patt502090/smart-voting-machine/temp/เครื่องลงคะแนนเสียงอัจฉริยะด้วย Arduino_ESP32.pdf

เครื่องลงคะแนนเสยงอัจฉริยะด้วย ี | Arduino/ESP32

## บทน;ำ

เครื่องลงคะแนนเสียงอัจฉริยะคือระบบเลือกตังอิเล็กทรอนิกส์ที่ผสมผสานเทคโนโลยีหลายอย่างเพื่อให้การลงคะแนนมีความ ้
ปลอดภัย โปร่งใส และรวดเร็ว ระบบนี้ใชไมโครคอนโทรลเลอร์ ้ | (เชน่ Arduino หรือ ESP32) ควบคุมอุปกรณ์ต่าง ๆ เชน่ เครื่อง
อ่านบัตร RFID, เซ็นเซอร์ลายนิ้วมือ, จอแสดงผล LCD, ปุ่มกดส;าหรับเลือกผู้สมัคร และโมดูลสื่อสาร Wi-Fi เพื่อส่งผลการโหวต ไปยังคอมพิวเตอร์แบบเรียลไทม์นอกจากนี้ยังสามารถต่อเครื่องพิมพ์ความร้อนขนาดเล็กเพื่อพิมพ์ใบเสร็จยืนยันการลงคะแนนให้
ผู้ใชได้ ้ ระบบได้รับการออกแบบให้รองรับทังโหมดการลงคะแนนแบบเลือกได้คนเดียว ้ | (Single Vote) และแบบเลือกได้หลายคน
พร้อมกัน (Multi-Choice Vote) สูงสุด 5 คน โดยมีมาตรการปองกันไม่ให้ผู้ใช ้ | คนเดียวลงคะแนนซ;้าด้วยการยืนยันตัวบุคคลสอง ้
ขันตอน ้ | (บัตร RFID และลายนิ้วมือ) | ทังนี้ ้ ตัวเครื่องต้นแบบถูกประกอบในกล่องหรือโครงสร้างที่ท;าจากกระดาษลัง DIY
เพื่อความสวยงามและสะดวกในการน;าเสนอผลงาน
คณสมบัติหลักของระบบ ุ | :
- โหมดกำรลงคะแนน: สามารถสลับระหว่างโหมดเลือกได้คนเดียว กับโหมดเลือกได้หลายคน (สูงสุด 5 คน) ตามประเภทของการ เลือกตัง้
- กำรยืนยันตัวตนสองชนั้ : ผู้มีสิทธิลงคะแนนต้องแตะบัตร ์ | RFID และสแกนลายนิ้วมือก่อนลงคะแนน เพื่อปองกันการ ้
ปลอมแปลงและลงคะแนนซ;้า ผู้ใชแต่ละคนจะลงคะแนนได้เพียงครั ้ | งเดียวเท่านั ้ | น้ หากมีการพยายามลงคะแนนซ;้า ระบบจะปฏิเสธ
ทันที
- ส่วนติดต่อผู้ใช:้ มีจอ LCD ส;าหรับแสดงค;าแนะน;า/สถานะการท;างาน และปุ่มกดสูงสุด 8 ปุ่มส;าหรับเลือกผู้สมัครที่ต้องการลง คะแนน (รองรับผู้สมัครได้สูงสุด 8 คน)
- กำรส่งข้อมูลผลโหวต: ใชความสามารถ ้ | Wi-Fi ของ ESP32 ในการส่งข้อมูลผลการลงคะแนนไปยังคอมพิวเตอร์ (เชน่
ODROID หรือ PC) แบบไร้สาย เพื่อแสดงผลคะแนนบนแดชบอร์ดแบบเรียลไทม์ผู้ควบคุมสามารถดูผลคะแนนสะสมได้ทันทีที่มี การลงคะแนนใหม่เข้ามา
- กำรพิมพ์ใบยืนยัน: หลังจากผู้ใชลงคะแนนส;าเร็จ ้ | ระบบสามารถพิมพ์ใบเสร็จยืนยันการลงคะแนนผ่านเครื่องพิมพ์ความร้อน
(thermal printer) ขนาดเล็ก เพื่อให้ผู้ลงคะแนนตรวจสอบว่าเสียงของตนถูกบันทึกเรียบร้อย (แนวคิดคล้าย VVPAT ในการ
เลือกตังจริง ้ | )
- กำรออกแบบโครงสร้ำง: ชุดอุปกรณ์ทังหมดติดตั ้ | งอยู่ในกล่องหรือคูหาท;าจากวัสดุอย่างกระดาษลัง ้ | ซึ่งออกแบบ DIY ให้
ดูเหมือนตู้ลงคะแนนเสียงขนาดเล็ก มีความแข็งแรงพอประมาณและตกแต่งให้สวยงาม เหมาะแก่การน;าไปแสดงในงานโครงงาน นักศึกษา
ด้านล่างนี้จะเป็นรายละเอียดเชงลึกของระบบ ิ | ตังแต่ส่วนประกอบฮาร์ดแวร์ ้ | การต่อวงจร ผังงานการท;างาน โค้ดโปรแกรมทังฝั ้ ่ง
ไมโครคอนโทรลเลอร์และฝั่งคอมพิวเตอร์ รวมถึงวิธีเตรียมฐานข้อมูลผู้มีสิทธิและขั ์ | นตอนการท;างานของระบบแบบเป็นล;าดับ ้

## อุปกรณ์และกำรต่อวงจร

ระบบประกอบด้วยฮาร์ดแวร์ส;าคัญหลายรายการดังต่อไปนี้:

ไมโครคอนโทรลเลอร์: สามารถใช้Arduino UNO/MEGA หรือ ESP32 เป็นหน่วยประมวลผลกลางของระบบ (แนะน;า
ใช้ESP32 เพื่อความสะดวกในการเช่อมต่อ ื | Wi-Fi ในตัว)
เครื่องอ่ำน RFID: โมดูล MFRC522 (RFID RC522) ใชส;าหรับอ่านบัตรประจ;าตัวผู้มีสิทธิ ้ | ลงคะแนน ความถี่ ์ | 13.56
MHz สื่อสารผ่านอินเทอร์เฟซแบบ SPI

1 (https://www.researchgate.net/publication/347968409_Arduino_Based_Authenticated_Voting_Machine_AVM_using_RFID_and_Fingerprint_for_the_Student_Elections) 2

2 (https://www.researchgate.net/publication/347968409_Arduino_Based_Authenticated_Voting_Machine_AVM_using_RFID_and_Fingerprint_for_the_Student_Elections)

•

•

3 (https://www.researchgate.net/publication/347968409_Arduino_Based_Authenticated_Voting_Machine_AVM_using_RFID_and_Fingerprint_for_the_Student_Elections)

เซนเซอร์ลำยนิ ็ | ้วมือ: โมดูล AS608 (หรือรุ่นใกล้เคียงเชน ่ R305) ใชสแกนลายนิ ้ | ้วมือผู้ลงคะแนน ตัวโมดูลมีหน่วยความ
จ;าภายในส;าหรับเก็บเทมเพลตลายนิ้วมือประมาณ 128 ลายนิ้วมือ และสื่อสารผ่านพอร์ตอนุกรม (UART) กับไมโคร คอนโทรลเลอร์
จอ LCD: จอแสดงผลตัวอักษร 16x2 (16 คอลัมน์ 2 แถว) หรือ 20x4 เพื่อใชแสดงข้อความสถานะต่าง ๆ เช ้ | น พร้อมให้ ่
ลงคะแนน, ยืนยันตัวตน, ข้อผิดพลาด เป็นต้น (ในที่นี้จะอ้างอิง 16x2 เพื่อความง่าย)
ปุ่มกด (Push Buttons): ใชส;าหรับเลือกผู้สมัครที่ต้องการลงคะแนน โดยสามารถมีได้สูงสุด ้ | 8 ปุ่ม (รองรับผู้สมัคร 8
หมายเลข) การต่อวงจรจะใชปุ่มแบบ ้ | Momentary (กดติดปล่อยดับ) ต่อลงไปยังขาพอร์ตดิจิทัลของไมโครคอนโทรล
เลอร์ พร้อมตัวต้านทาน Pull-down หรือใช้Internal Pull-up ของ MCU เพื่อให้ตรวจจับสถานะการกดได้
บัซเซอร์/LED (อุปกรณ์เสริม): บัซเซอร์ใชส่งเสียงแจ้งเตือนเมื่อมีเหตุการณ์บางอย่าง เช ้ | น สแกนบัตรผ่านหรือเกิดข้อ ่
ผิดพลาด LED สีเขียว/แดงสามารถใชแสดงสถานะพร้อมลงคะแนนหรือการยืนยันตนผ่าน ้ | (อุปกรณ์เสริมนี้ไม่ได้ระบุใน
คุณสมบัติหลัก แต่สามารถเพิมได้เพื่อเพิ ่ | มประสบการณ์ผู้ใช ่ | ) ้
โมดูล Wi-Fi: หากใช้ESP32 จะมี Wi-Fi ในตัว แต่หากใช้Arduino อาจต้องต่อโมดูล Wi-Fi แยกต่างหาก (เชน่ ESP8266) อย่างไรก็ตาม ในที่นี้เราเลือกใช้ESP32 เป็นหลักเพราะรวม Wi-Fi กับ MCU ไว้ในตัวเดียว
เครื่องพิมพ์ควำมร้อน (Thermal Printer): เป็นเครื่องพิมพ์ใบเสร็จขนาดเล็กที่ใชกระดาษความร้อน ้ | 58 มม. เช่อมื
ต่อผ่าน Serial TTL (ต้องการไฟเลี้ยง 5V แยกต่างหาก) เพื่อพิมพ์ข้อความยืนยันการลงคะแนนเมื่อโหวตส;าเร็จ (การต่อ พ่วงเป็นทางเลือกเพิมเติม ่ )
ส;าหรับการต่อวงจร Arduino/ESP32 กับอุปกรณ์ข้างต้น มีรายละเอียดดังนี้:

กำรต่อโมดูล RFID RC522: โมดูล RC522 ท;างานที่ไฟ 3.3V (ควรใช 3.3V ้ เพื่อความปลอดภัยของตัวโมดูล) และ สื่อสารด้วย SPI ขาของ RC522 ได้แก่ SDA (SS), SCK, MOSI, MISO, IRQ, RST, 3.3V, GND โดยการต่อกับ ESP32 (ตัวอย่างใช้ESP32 DevKit V1) จะต่อ SDA → GPIO 5, SCK → GPIO 18, MOSI → GPIO 23, MISO →
GPIO 19, RST → GPIO 21, และใชไฟ้ 3.3V, GND ตามล;าดับ | (ESP32 สามารถปรับเปลี่ยนขา SPI ได้ แต่
ตัวอย่างนี้ใช้SPI ชุดเริมต้น ่ | (VSPI) ของ ESP32)
กำรต่อเซนเซอร์ลำยนิ ็ | ้วมือ: โมดูล AS608 มีสายเช่อมต่อ ื | 4 เส้นหลักคือ VCC (ไฟเลี้ยง 3.3V-5V), GND, TX, RX โดย
TX/RX ของเซ็นเซอร์จะต่อเข้ากับ RX2 และ TX2 ของ ESP32 (หรือหากใช้Arduino UNO สามารถใช้
SoftwareSerial ในการรับส่งข้อมูลได้) การเช่อมต่อคือเซ็นเซอร์ ื | TX → RX ของ MCU, เซ็นเซอร์ RX → TX ของ
MCU และจ่ายไฟให้เซ็นเซอร์ที่ 3.3V หรือ 5V ตามสเปค (AS608 รองรับ 3.3V)
กำรต่อจอ LCD 16x2: ถ้าใชจอ ้ LCD พร้อม I2C backpack จะง่ายขึ้น โดยต่อเพียง 4 เส้นคือ VCC (5V), GND, SDA, SCL จากโมดูล I2C ไปยังขา SDA/SCL ของ MCU (เชน ่ SDA → GPIO 21, SCL → GPIO 22 บน ESP32 หรือ
A4, A5 บน Arduino UNO ตามล;าดับ) | แต่หากใชการต่อแบบขนาน ้ | 4-bit (ไม่มี I2C backpack) จะต้องต่อสาย
หลายเส้น: ขา RS, EN, D4-D7 ของ LCD ไปยังขาดิจิทัลของ MCU และต่อไฟเลี้ยง/ปรับแสงตามปกติ (ในตัวอย่าง Arduino UNO: RS→D13, EN→D12, D4→D11, D5→D10, D6→D9, D7→D8)
กำรต่อปุ่มกด: ปุ่มกดแต่ละตัวมีขา 2 ขา (หรือ 4 ขาส;าหรับปุ่มแบบมีขาเผื่อ) การต่อวงจรนิยมต่อแบบหนึ่งขาเข้าขา อินพุตของ MCU และอีกขาหนึ่งลง GND จากนันใช ้ ้Pull-up ภายใน MCU (INPUT_PULLUP) เพื่อให้สถานะปกติของ ปุ่มเป็น HIGH และเมื่อกดจะต่อขาเข้าลง GND (อ่านค่า LOW เมื่อกด) ซึ่งวิธีนี้ลดจ;านวนอุปกรณ์เพราะไม่ต้องใชตัว ้ ต้านทานภายนอก (หรือจะต่อแบบหนึ่งขาเข้าขาอินพุต หนึ่งขาไป VCC และใช้Pull-down resistor ก็ได้) แต่หลักการคือ เมื่อกดปุ่มให้เกิดการเปลี่ยนสถานะโลจิกที่ตรวจจับได้
กำรต่อบัซเซอร์/LED: (ถ้ามี) บัซเซอร์แอคทีฟ 5V สามารถต่อขา + ไปขา MCU (ผ่านทรานซิสเตอร์ถ้ากระแสเกิน) และขา
– ลง GND เพื่อให้ MCU สังเสียงได้ ส;าหรับ ่ | LED ให้ต่อขา Anode ผ่านตัวต้านทาน ~220Ω ไปยังขา MCU และขา
Cathode ลง GND (ไฟ 3.3V ของ ESP32 สามารถไดรฟ LED ได้โดยตรง) ด้านล่างเป็นแผนภาพบล็อกและแผนผังวงจรเพื่อความเข้าใจในการต่อระบบทังหมด ้ :

แผนภาพบล็อกของระบบเครื่องลงคะแนนเสียงแบบ biometric (ยืนยันตัวบุคคลด้วยลายนิ้วมือและ RFID) โดยมีไมโครคอนโทรล
เลอร์ Arduino เป็นศูนย์กลางเช่อมต่อกับจอ ื | LCD (ส;าหรับแสดงผลข้อความ), โมดูลสแกนลายนิ้วมือ, เครื่องอ่านบัตร RFID และ
ปุ่มกดส;าหรับลงคะแนน | แต่ละองค์ประกอบท;างานร่วมกันเพื่อให้การลงคะแนนมีความปลอดภัยและแม่นย;า

•

•

•

•

•

•

•

4 (https://randomnerdtutorials.com/esp32-mfrc522-rfid-reader-arduino/)

•

•

5 (https://www.electroniclinic.com/rfid-fingerprint-based-advanced-security-system-using-arduino/)

6 (https://circuitdigest.com/microcontroller-projects/fingerprint-based-biometric-voting-machine-arduino)
•

•

7 (https://transmitter.ieee.org/makerproject/view/01ccd)

จากแผนภาพบล็อกข้างต้น จะเห็นว่าหลังจากผู้ใชได้รับการตรวจสอบสิทธิ ้ | ผ่าน ์ | RFID และลายนิ้วมือ ไมโครคอนโทรลเลอร์จะ
อนุญาตให้กดปุ่มลงคะแนนเลือกผู้สมัครที่ต้องการ จากนันจึงบันทึกและส่งผลไปยังส่วนประมวลผลผลโหวตผ่าน ้ | Wi-Fi โดยจะ
แสดงผลบนคอมพิวเตอร์แบบเรียลไทม์ ขันตอนเหล่านี้จะถูกอธิบายอย่างละเอียดในส่วนถัดไป ้
แผนผังวงจรการเช่อมต่ออุปกรณ์ทั ื | งหมด ้ | (ตัวอย่างการใช้ Arduino Uno): โมดูลสแกนลายนิ้วมือต่อเข้าขา Tx/Rx ของ
Arduino, จอ LCD ต่อในโหมด 4-bit (ขา RS, EN, D4-D7 ต่อเข้าขา D13,D12,D11,D10,D9,D8 ของ Arduino), และปุ่มกด
หลายตัวต่อเข้าขาอินพุตส;าหรับผู้สมัคร CAN1, CAN2, CAN3 (ในภาพตัวอย่างมี 3 ผู้สมัคร) พร้อมทังปุ่มส;าหรับฟังก์ช ้ | นอื่นๆ ั | เชน่
Enroll, Delete เป็นต้น (ต่อเข้าขา A0-A4) | ในการใชงานจริงสามารถเพิ ้ | ่มจ;านวนปุ่มผู้สมัครได้ถึง 8 ปุ่มตามที่ระบบต้องการ

หมำยเหตุ: หากใช้ESP32 แทน Arduino ในการต่อวงจรจริง ขา I/O บน ESP32 จะต่างออกไป แต่หลักการ
ต่อเหมือนกัน (RFID ใช SPI, ้ | เซ็นเซอร์ลายนิ้วมือใช UART, ้ | จอ LCD ใช I2C ้ | หรือ 4-bit parallel, ปุ่มกดต่อเข้า
GPIO ทัวไป ่ ) ต้องระมัดระวังเรื่องแรงดันไฟ: ESP32 ท;างานที่ระดับตรรกะ 3.3V ดังนันโมดูลทั ้ | งหมดควรใช ้ | ้
3.3V หรือต่อวงจรแปลงระดับแรงดัน (logic level shifter) ถ้าจ;าเป็น (เชน่ จอ LCD 16x2 ถ้าไม่มี I2C module อาจต้องใช 5V ้ แต่ว่าสัญญาณจาก ESP32 3.3V ก็มักเพียงพอในการขับให้ LCD รับรู้เป็น High ได้)

เมื่อฮาร์ดแวร์ทุกส่วนต่อครบถ้วนดังผังวงจรแล้ว ก็พร้อมส;าหรับการเขียนโปรแกรมควบคุมส่วนต่าง ๆ และด;าเนินการตาม ขันตอนการลงคะแนนเสียง ซึ่งจะอธิบายในล;าดับถัดไป ้

## ผังงำนของระบบ

ด้านล่างเป็นผังงาน (Flowchart) โดยสรุปขันตอนการท;างานของเครื่องลงคะแนนเสียงอัจฉริยะ ้ | ตังแต่การเริ ้ | มต้นระบบไปจนถึง ่
จบการลงคะแนนในแต่ละคน
ผังงานแสดงล;าดับกระบวนการของระบบลงคะแนนเสียง: เริมจากรอให้ผู้ใช ่ | สแกนบัตร ้ | RFID และลายนิ้วมือเพื่อยืนยันสิทธิ์ หาก
ตรวจสอบผ่านและยังไม่เคยลงคะแนนมาก่อน ระบบจะอนุญาตให้ลงคะแนนได้ แต่หากลายนิ้วมือไม่ตรงกับข้อมูลที่ลงทะเบียนไว้
หรือผู้ใชคนเดิมพยายามลงคะแนนซ;้า ระบบจะปฏิเสธการลงคะแนน ้ | (ยกเลิกกระบวนการ) | จากนันจึงวนกลับไปรอผู้ใช ้ | คนถัดไป ้

จากผังงานจะเห็นว่าระบบมีเงื่อนไขที่ส;าคัญคือ กำรตรวจสอบสิทธิ์ และ กำรตรวจจับกำรลงคะแนนซ้ำ; เพื่อรักษาความถูกต้อง ของการเลือกตัง กระบวนการละเอียดจะขยายความในหัวข้อถัดไป ้
ขันตอนกำรลงคะแนน ้ | (Step-by-Step Workflow)
เพื่อให้เข้าใจการท;างานของระบบอย่างเป็นล;าดับต่อเนื่อง ขอน;าเสนอขันตอนการลงคะแนนของผู้ใช ้ | หนึ่งคน ดังนี้ ้ | :
ผู้ใชแสดงตัวตนด้วยบัตร ้ | RFID: ผู้ลงคะแนนน;าบัตรประจ;าตัว (ที่มีแท็ก RFID) แตะที่เครื่องอ่าน RFID RC522 ที่หน้า
ตู้ เครื่องอ่านจะตรวจจับการ์ดและอ่านรหัสประจ;าบัตร (UID) ออกมาได้ส;าเร็จ (บัตร RFID ทุกใบจะมี UID ที่ไม่ซ;้ากันเพื่อ
ระบุผู้ถือบัตรแต่ละคน | )
ตรวจสอบ UID กับฐำนข้อมูลผู้มสิทธิ ี :์ ไมโครคอนโทรลเลอร์จะน;า UID ที่อ่านได้ไปค้นหาในรายช่อผู้มีสิทธิ ื | ในหน่วย ์
ความจ;า/ฐานข้อมูล หากไม่พบหมายเลขบัตรนี้ในระบบ แสดงว่าเป็นบัตรที่ไม่มีสิทธิหรือไม่ถูกต้อง ระบบจะแสดงผลบน ์
LCD ว่า “ไม่มีสิทธิ” ์ หรือ “Unauthorized” และกระบวนการจะสินสุดลงทันทีส;าหรับบุคคลนั ้ | น ้
ยืนยันตัวตนด้วยลำยนิ้วมือ: หาก UID บัตรตรงกับรายช่อผู้มีสิทธิ ื | ระบบจะแสดงข้อความบน ์ | LCD ให้ผู้ใช “้ วางนิ้วเพื่อ
ตรวจสอบ” จากนันผู้ใช ้ | ต้องวางนิ ้ | ้วที่ลงทะเบียนไว้บนเซ็นเซอร์ลายนิ้วมือ AS608 ระบบจะสแกนลายนิ้วมือและเทียบกับ
ข้อมูลลายนิ้วมือในฐานข้อมูลที่ผูกกับหมายเลขบัตร RFID นันๆ เพื่อยืนยันว่าบุคคลที่ถือบัตรคือเจ้าของสิทธิ ้ | ตัวจริง ์ | (การ
ใชสองปัจจัยนี้ช ้ | วยรับประกันว่าบัตรเป็นของเจ้าของที่แท้จริง ไม่ใช ่ | หยิบยืมผู้อื่นมา ่ | )
ตรวจสอบสถำนะกำรลงคะแนน: หากลายนิ้วมือตรงกับข้อมูลในระบบ (ผ่านการยืนยันตัวบุคคล) โปรแกรมจะตรวจเชค็
ต่อว่าผู้มีสิทธิรายนี้เคยลงคะแนนไปแล้วหรือยังโดยการดูสถานะ ์ | “hasVoted” ในฐานข้อมูลของบุคคลนันๆ้ – ถ้าพบว่า
เคยลงคะแนนแล้ว ระบบจะปฏิเสธการลงคะแนนซ;้าทันที จะแจ้งเตือนบนหน้าจอว่า “คุณได้ลงคะแนนแล้ว” และสินสุด ้

6 (https://circuitdigest.com/microcontroller-projects/fingerprint-based-biometric-voting-machine-arduino)

2 (https://www.researchgate.net/publication/347968409_Arduino_Based_Authenticated_Voting_Machine_AVM_using_RFID_and_Fingerprint_for_the_Student_Elections)

1.

8 (https://www.researchgate.net/publication/347968409_Arduino_Based_Authenticated_Voting_Machine_AVM_using_RFID_and_Fingerprint_for_the_Student_Elections)
2.

3.

9 (https://www.researchgate.net/publication/347968409_Arduino_Based_Authenticated_Voting_Machine_AVM_using_RFID_and_Fingerprint_for_the_Student_Elections)
4.

| กระบวนการส;าหรับผู้ใชรายนี้ ้ | (มาตรการนี้ท;าให้หนึ่งคนลงคะแนนได้เพียงหนึ่งครังตามหลักการ ้ | | one person, one vote
)
เลือกรูปแบบกำรลงคะแนน (Single/Multi): กรณีผู้ใชยังไม่เคยลงคะแนน ระบบจะเข้าสู่โหมดลงคะแนน โดยจะแสดง ้
ข้อความให้เลือกผู้สมัครบนจอ LCD (เชน่ “เลือกผู้สมัคร”) โหมดการลงคะแนนขึ้นอยู่กับการตังค่าของระบบในขณะนั ้ | น้ :
โหมดเลือกคนเดียว: ระบบจะอนุญาตให้กดปุ่มเลือกผู้สมัครได้เพียงคนเดียว เมื่อผู้ใชกดปุ่มหมายเลขผู้สมัคร ้ | (เชน ปุ่ม ่
หมายเลข 3 เพื่อเลือกผู้สมัครหมายเลข 3) ระบบจะบันทึกตัวเลือกนันแล้วถือว่าการลงคะแนนเสร็จสิ ้ | น ้
โหมดเลือกหลายคน: ระบบจะอนุญาตให้เลือกผู้สมัครได้หลายคนภายในการลงคะแนนครังเดียว ้ | (เชน เลือกได้สูงสุด ่ | 5
คน) กรณีนี้ผู้ใชสามารถกดปุ่มผู้สมัครได้ทีละคน ระบบจะนับจ;านวนที่เลือกไป และแสดงผลจ;านวนที่เลือกแล้ว ้ | /จ;านวนสูง
สุดบน LCD (เชน่ “เลือกแล้ว 2/5”) ผู้ใชจะกดจนครบตามจ;านวนที่อนุญาต ระบบจะไม่อนุญาตให้เลือกเกินที่ก;าหนด ้ | (ถ้า
ครบ 5 คนแล้ว ปุ่มที่กดเพิมเติมจะไม่มีผล หรืออาจต้องมีปุ่ม ่ | “ยืนยัน” แยกต่างหากเพื่อสินสุดการเลือก ้ | )
บันทึกผลโหวต: เมื่อผู้ใชเลือกผู้สมัครครบตามที่ระบบก;าหนดในโหมดนั ้ | นๆ แล้ว ไมโครคอนโทรลเลอร์จะท;าการบันทึก ้
คะแนนเสียงลงในตัวแปรหรือหน่วยความจ;าที่เก็บ ตัวนับคะแนน ของผู้สมัครแต่ละคน โดยจะเพิมค่า ่ | +1 ให้แก่ผู้สมัครที่
ถูกเลือก (ส;าหรับโหมดเลือกหลายคน ผู้สมัครแต่ละคนที่ถูกเลือกจะได้ +1 ในตัวนับคะแนนของตน)
อัปเดตสถำนะผู้ใช:้ ระบบท;าเครื่องหมายในฐานข้อมูลว่าผู้ใชคนนี้ ้ | “ลงคะแนนแล้ว” (เชน ตั ่ งค่าตัวแปร ้ | hasVoted =
true ส;าหรับผู้ใชรายนี้ ้ | ) เพื่อปองกันไม่ให้เขากลับมาลงคะแนนซ;้าอีกในภายหลัง ้
ส่งข้อมูลผลกำรเลือกตั้งไปยังเซร์ฟเวอร์ ิ | : หลังการบันทึกคะแนนในเครื่องแล้ว ไมโครคอนโทรลเลอร์ (ESP32) จะท;า
การส่งข้อมูลผลการลงคะแนนไปยังคอมพิวเตอร์แม่ข่าย (Server) ผ่านทาง Wi-Fi ทันที ข้อมูลที่ส่งอาจเป็นรายละเอียด การโหวตครังนี้หรือยอดรวมคะแนนล่าสุดของทุกผู้สมัครก็ได้ ข้อมูลจะถูกส่งด้วยรูปแบบที่ตกลงกันระหว่างไมโคร ้ คอนโทรลเลอร์กับโปรแกรมฝั่งคอมพิวเตอร์ (อาจใช้HTTP request, WebSocket หรือ MQTT แล้วแต่การออกแบบ ในที่นี้จะยกตัวอย่างการส่งผ่าน HTTP) เมื่อเซิร์ฟเวอร์ได้รับข้อมูลแล้ว จะน;าไปปรับปรุงแดชบอร์ดแสดงผลคะแนนแบบ
| เรียลไทม์บนหน้าจอคอมพิวเตอร์
กำรพิมพ์ใบยืนยัน (ถ้ำม):ี หากระบบมีการต่อเครื่องพิมพ์ความร้อนไว้ ไมโครคอนโทรลเลอร์จะสังพิมพ์ใบเสร็จยืนยันการ ่
ลงคะแนนให้แก่ผู้ใช เช้ น พิมพ์ข้อความว่า ่ | “การลงคะแนนเสร็จสมบูรณ์”, รหัสของผู้ใช (้ หรือหมายเลขบัตร) และเวลาที่ลง
คะแนน เป็นต้น ทังนี้เพื่อเป็นหลักฐานให้ผู้ลงคะแนนสามารถตรวจสอบความถูกต้องในภายหลัง ้ | (ข้อความในใบเสร็จจะไม่
ระบุช่อผู้สมัครที่เลือก เพื่อรักษาความลับของบัตรเลือกตั ื | ง้ )
สินสุดและพร้อมรับคนถัดไป ้ | : ระบบแสดงข้อความ “ลงคะแนนส;าเร็จ” หรือข้อความขอบคุณบน LCD สักครู่ จากนันจะรี ้
เซ็ตกลับไปสู่สถานะพร้อมใชงานส;าหรับผู้มีสิทธิ ้ | คนถัดไป ์ | (กลับไปที่ขันตอนรอบัตร ้ | RFID) โดยหากมีไฟ LED สถานะก็อาจ
กระพริบแจ้งเตือนสัน ๆ ร่วมด้วยว่ากระบวนการส;าหรับคนนี้เสร็จสิ ้ | นแล้ว ้
ขันตอนข้างต้นจะเกิดขึ้นซ;้า ้ | ๆ ทุกครังที่มีผู้มาใช ้ | สิทธิ ้ ลงคะแนนจนกว่าจะครบทุกคนหรือจนกว่าจะสิ ์ | นสุดเวลาลงคะแนน ้ | ข้อมูลผล
การลงคะแนนทุกครังจะถูกบันทึกไว้ทั ้ | งในตัวเครื่องและส่งไปยังระบบศูนย์กลางตลอดเวลาเพื่อความโปร่งใสและปลอดภัย ้
กำรเตรยมฐำนข้อมูลผู้ม ี | สิทธิ ี ์
ระบบนี้ต้องมีฐำนข้อมูลรำยช่อผู้ม ื | สิทธิ ี ์ที่ประกอบด้วยข้อมูลสองส่วนที่เช่อมโยงกัน ื | ได้แก่ รหัสบัตร RFID และ เทมเพลตลำย
นิ้วมือ ของผู้มีสิทธิแต่ละคน ์ | การเตรียมฐานข้อมูลนี้ควรท;าเป็นขันตอนก่อนวันใช ้ | งานจริง ้ | (pre-enrollment) โดยอาจด;าเนินการ
ดังนี้:
กำรลงทะเบยนบัตร ี | RFID: แจกจ่ายบัตร RFID ให้แก่ผู้มีสิทธิแต่ละคน ์ | (เชน นักศึกษาแต่ละคนในกรณีเลือกตั ่ | งองค์การ ้
นักศึกษา) จากนันอ่าน ้ | UID ของบัตรแต่ละใบและบันทึกลงในระบบพร้อมเช่อมโยงกับข้อมูลบุคคล ื | (เชน ช ่ ่อ หรือรหัส ื
นักศึกษา เพื่อทราบว่า UID ใดเป็นของใคร)
กำรเก็บลำยนิ้วมือ: ใชเซ็นเซอร์ลายนิ ้ | ้วมือ AS608 เช่อมต่อกับ ื | Arduino/ESP32 รันโปรแกรม enrollment (มีอยู่ใน
ไลบรารีของ Adafruit) เพื่อบันทึกลายนิ้วมือของผู้มีสิทธิแต่ละคนลงในหน่วยความจ;าของโมดูล โดยจะก;าหนด ์ | รหัส
ประจ;ำลำยนิ้วมือ (Finger ID) ให้แต่ละคน (เชน่ 001, 002, … ตามล;าดับ) ในขันตอนนี้ผู้ลงทะเบียนจะต้องวางนิ ้ | ้ว 2-3
ครังตามที่ระบบแจ้งเพื่อบันทึกลายนิ ้ | ้วมือให้คมชดครบถ้วน เมื่อบันทึกแล้ว เทมเพลตลายนิ ั | ้วมือจะถูกจัดเก็บในโมดูล
AS608 และสามารถค้นหาหรือเปรียบเทียบได้ภายหลัง
เช่อมโยงข้อมูลสองส่วน ื | : ในโปรแกรมของไมโครคอนโทรลเลอร์จะต้องมี โครงสร้ำงข้อมูล ส;าหรับเก็บรายช่อผู้มีสิทธิ ื | ์
อาจท;าเป็นอาเรย์ของโครงสร้าง (struct) ที่มีฟิลด์เก็บ UID ของบัตร (ความยาว 4 ไบต์ส;าหรับบัตร Mifare 1K ทัวไป ่ ), หมายเลข ID ลายนิ้วมือที่บันทึกไว้ในเซ็นเซอร์ และสถานะการลงคะแนน (ยังไม่ได้โหวต/โหวตแล้ว) ดังตัวอย่าง:

2 (https://www.researchgate.net/publication/347968409_Arduino_Based_Authenticated_Voting_Machine_AVM_using_RFID_and_Fingerprint_for_the_Student_Elections)
5.

6.

7.

8.

9.

2 (https://www.researchgate.net/publication/347968409_Arduino_Based_Authenticated_Voting_Machine_AVM_using_RFID_and_Fingerprint_for_the_Student_Elections)
10.

11.

12.

•

•

•

struct Voter {
uint8_t rfidUid[4];
uint16_t fingerId;
bool hasVoted;
};

Voter votersDB[] = {
{{0xDE,0xAD,0xBE,0xEF}, 1, false}, // ตัวอย่าง: UID = DE AD BE EF, Finger ID = 1
{{0xA1,0xB2,0xC3,0xD4}, 2, false}, // ตัวอย่าง: UID = A1 B2 C3 D4, Finger ID = 2
// ... (เพิมตามจ;านวนผู้มีสิทธิ ่ | )์
};
int totalVoters = sizeof(votersDB)/sizeof(votersDB[0]);

ในตัวอย่างข้างต้น เราเตรียมข้อมูลผู้มีสิทธิ์ 2 คน (ในทางปฏิบัติอาจมีหลายสิบหรือหลักร้อยคนก็ได้) โดยคนแรกมี UID ของบัตร RFID = DEADBEEF (เขียนในรูป hexadecimal) และมีลายนิ้วมือเก็บอยู่ในเซ็นเซอร์ที่ต;าแหน่ง ID หมายเลข 1 ส่วนคนที่สอง UID = A1B2C3D4, Finger ID = 2 เป็นต้น ค่า hasVoted เริมต้นเป็น ่ false แปลว่ายังไม่ได้ใชสิทธิ ้ ์

น;ำเข้ำข้อมูลสู่หน่วยควำมจ;ำ: ในที่นี้เลือกเก็บฐานข้อมูลในหน่วยความจ;าของไมโครคอนโทรลเลอร์เพื่อความง่าย (เนื่อง
จากจ;านวนผู้มีสิทธิไม่มากนัก ์ | ) แต่หากต้องการขยาย สามารถใชหน่วยความจ;าเสริม ้ | (เชน่ EEPROM, microSD) หรือ
เช่อมต่อกับฐานข้อมูลภายนอก ื | (ผ่าน Wi-Fi ไปยังเซิร์ฟเวอร์กลาง) ก็ได้ตามความเหมาะสม | ระบบควรโหลดรายช่อผู้ ื
มีสิทธินี้ในขั ์ | นตอนเริ ้ | มต้น ่ | ( setup() ) เพื่อเตรียมพร้อมส;าหรับการตรวจสอบขณะลงคะแนนจริง
รักษำควำมปลอดภัยของข้อมูล: ควรจ;ากัดการเข้าถึง/แก้ไขฐานข้อมูลผู้มีสิทธิเฉพาะผู้ดูแลระบบเท่านั ์ | น้ เพื่อปองกันการ ้
เพิมช่ ่อหรือลบช ื | ่อโดยไม่ได้รับอนุญาต ื | นอกจากนี้เมื่อการเลือกตังสิ ้ นสุด ้ | ควรล้างข้อมูลลายนิ้วมือออกจากเซ็นเซอร์เพื่อ
ลดความเสี่ยงด้านความเป็นส่วนตัวของข้อมูลชวมิติ ี
การเตรียมฐานข้อมูลที่ถูกต้องและเช่อถือได้เป็นรากฐานส;าคัญของระบบนี้ ื | เพราะหากข้อมูลผิดพลาด (เชน่ ลายนิ้วมือไม่ตรงกับ
บัตร, รายช่อขาดตก ฯลฯ ื | ) จะท;าให้ผู้มีสิทธิบางคนไม่สามารถลงคะแนนหรือเกิดปัญหาในขั ์ | นตอนยืนยันตัวตนได้ ้

## โปรแกรมบนไมโครคอนโทรลเลอร์ (Arduino/ESP32)

ต่อไปจะเป็นส่วนของซอฟต์แวร์ที่รันบนไมโครคอนโทรลเลอร์ เพื่อควบคุมอุปกรณ์และด;าเนินการตามขันตอนที่ได้อธิบายไปแล้ว ้ โค้ดต่อไปนี้จัดท;าขึ้นส;าหรับแพลตฟอร์ม ESP32 (สามารถปรับใชกับ้ Arduino ได้โดยแก้ไขไลบรารี Wi-Fi และพอร์ต Serial ตาม
ความเหมาะสม) โค้ดนี้ครอบคลุมการท;างานตังแต่การอ่าน ้ | RFID, สแกนลายนิ้วมือ, รับอินพุตจากปุ่ม, ส่งข้อมูลผ่าน Wi-Fi และ
ควบคุม LCD รวมถึงการพิมพ์ใบเสร็จ (ในรูปแบบความคิดเห็น) โดยมีค;าอธิบายเป็นตอน ๆ ภายในโค้ด:

#include <SPI.h>

#include <MFRC522.h> | // ไลบรารีส;าหรับโมดูล RFID RC522

#include <WiFi.h> | // ไลบรารี Wi-Fi ส;าหรับ ESP32

#include <HTTPClient.h> | // ไลบรารีส;าหรับส่ง HTTP requests

#include <Adafruit_Fingerprint.h> // ไลบรารีเซ็นเซอร์ลายนิ้วมือ (Adafruit) #include <LiquidCrystal_I2C.h> // ไลบรารีจอ LCD ผ่าน I2C

// ก;าหนดขาส;าหรับ RC522 (ใชชุด ้ SPI พื้นฐานของ ESP32)
#define RFID_SDA 5 // SS (SDA) ของ RC522 ต่อกับ GPIO5

•

2 (https://www.researchgate.net/publication/347968409_Arduino_Based_Authenticated_Voting_Machine_AVM_using_RFID_and_Fingerprint_for_the_Student_Elections)

•

#define RFID_RST 21 // RST ของ RC522 ต่อกับ GPIO21 MFRC522 mfrc522(RFID_SDA, RFID_RST); // สร้างอ็อบเจ็กต์ RC522

// ก;าหนด UART ส;าหรับเซ็นเซอร์ลายนิ้วมือ (ใช้UART2 บน ESP32)
HardwareSerial FingerSerial(2);
// หมายเหตุ: ต้องก;าหนดขา RX, TX ของ UART2 ตอน begin (ค่าเริม ่ RX2=16, TX2=17 บนบางบอร์ด)
Adafruit_Fingerprint finger(&FingerSerial);

// ก;าหนดจอ LCD I2C (ที่อยู่ 0x27 ขนาด 16x2)
LiquidCrystal_I2C lcd(0x27, 16, 2);

// ก;าหนดขาปุ่มผู้สมัคร (ตัวอย่างใช้8 ปุ่มกับขา GPIO ตามล;าดับ)
int candidateButtons[8] = {13, 12, 14, 27, 26, 25, 33, 32};
int numCandidates = 8;

// ก;าหนดโหมดการลงคะแนน (false = โหมดเลือกคนเดียว, true = โหมดเลือกหลายคน)
bool multiMode = false;
int maxSelections = 5; // จ;านวนสูงสุดที่เลือกได้ในโหมดหลายคน (เริมต้น ่ 5)

// โครงสร้างและฐานข้อมูลผู้มีสิทธิ์(ตัวอย่าง)
struct Voter {
uint8_t rfidUid[4];
uint16_t fingerId;
bool hasVoted;
} votersDB[] = {
{{0xDE,0xAD,0xBE,0xEF}, 1, false}, {{0xAA,0xBB,0xCC,0xDD}, 2, false}
// สามารถเพิมรายการตามจ;านวนผู้มีสิทธิ ่ | ์
};
int totalVoters = sizeof(votersDB) / sizeof(votersDB[0]);

// ตัวแปรเก็บผลคะแนนของผู้สมัคร (เริมต้น ่ 0 ทุกคน)
int voteCounts[8] = {0};
// ข้อมูลการเช่อมต่อ ื | Wi-Fi และเซิร์ฟเวอร์ (แก้ไขตามสภาพแวดล้อมจริง)
const char* ssid | = "YourWiFiSSID";
const char* password = "YourWiFiPassword";
const char* serverURL = "http://192.168.1.100:5000/update"; // URL ส;าหรับส่งผล
คะแนน (ตัวอย่าง)

// ฟังก์ชนชั วยเหลือ ่ : เปรียบเทียบ UID ที่อ่านได้กับ UID ในฐานข้อมูล (คืน -1 ถ้าไม่พบ)
int findVoterByUID(uint8_t *uid, byte uidSize) {
for(int i = 0; i < totalVoters; i++) {
bool match = true;
for(byte j = 0; j < uidSize; j++) { if(votersDB[i].rfidUid[j] != uid[j]) { match = false;
break;
}
}

if(match) return i;
}
return -1;
}

void setup() {
Serial.begin(115200); | // เริมต้น ่ | Serial ส;าหรับ debug
lcd.init(); lcd.backlight(); // เริมต้นจอ ่ | LCD
lcd.print("Smart Voting"); // แสดงข้อความเปิดระบบ
// เริมต้นโมดูล ่ RFID
SPI.begin();
mfrc522.PCD_Init();
// เริมต้นโมดูลลายนิ ่ | ้วมือ
FingerSerial.begin(57600, SERIAL_8N1, 16, 17); // ก;าหนด UART2 RX=GPIO16, TX=GPIO17
finger.begin(57600);
if(finger.verifyPassword()) {
Serial.println("Fingerprint sensor OK");
} else {
Serial.println("Fingerprint sensor NOT found"); }
// ก;าหนดขา I/O ของปุ่มเป็น input pullup
for(int i = 0; i < numCandidates; i++) { pinMode(candidateButtons[i], INPUT_PULLUP); }
// เช่อมต่อ ื Wi-Fi
WiFi.begin(ssid, password);
lcd.setCursor(0,1); lcd.print("WiFi Connecting"); while(WiFi.status() != WL_CONNECTED) { delay(500);
Serial.print(".");
}
Serial.println("\nWiFi connected"); lcd.clear();
}

void loop() {
// 1. รอการสแกนบัตร RFID
if(!mfrc522.PICC_IsNewCardPresent() || !mfrc522.PICC_ReadCardSerial()) {
return; // วนลูปไปเรื่อย ๆ จนกว่าจะมีบัตรเข้ามาใหม่
}
// อ่าน UID ของบัตรที่เพิงสแกนได้ ่
uint8_t *uid = mfrc522.uid.uidByte; byte uidSize = mfrc522.uid.size; Serial.print("Card UID: "); for(byte i = 0; i < uidSize; i++) { Serial.printf("%02X ", uid[i]); }
Serial.println();
// 2. ตรวจสอบ UID กับฐานข้อมูลผู้มีสิทธิ์

int voterIndex = findVoterByUID(uid, uidSize);
if(voterIndex == -1) {
lcd.clear(); lcd.print("Unauthorized!"); // แสดงว่าไม่พบในฐานข้อมูล Serial.println("Unauthorized card.");
delay(3000);
mfrc522.PICC_HaltA(); // หยุดการอ่านบัตร
return;
}
// 3. ตรวจสอบว่าผู้ใชคนนี้เคยโหวตหรือยัง ้
if(votersDB[voterIndex].hasVoted) {
lcd.clear(); lcd.print("Already Voted"); // แจ้งว่าโหวตแล้ว Serial.println("Voter already voted.");
delay(3000);
mfrc522.PICC_HaltA();
return;
}
// 4. ขอให้สแกนลายนิ้วมือ
lcd.clear(); lcd.print("Scan Finger..."); Serial.println("Place finger for scanning...");
// พยายามอ่านลายนิ้วมือ (ให้โอกาส 3 ครัง้ )
int fingerprintResult = -1;
for(int attempt = 0; attempt < 3; attempt++) { if(finger.getImage() == FINGERPRINT_OK) { if(finger.image2Tz() == FINGERPRINT_OK) {
// ค้นหารอยนิ้วมือในฐานข้อมูลของโมดูล
if(finger.fingerSearch() == FINGERPRINT_OK) { fingerprintResult = finger.fingerID; // ได้ ID ลายนิ้วมือที่ตรง break;
}
}
}
delay(1000);
}
// ตรวจผลการสแกน
if(fingerprintResult != votersDB[voterIndex].fingerId) { lcd.clear(); lcd.print("Fingerprint Err"); // ลายนิ้วมือไม่ตรง Serial.println("Fingerprint mismatch or not found."); delay(3000);
mfrc522.PICC_HaltA();
return;
}
// 5. ผ่านการยืนยันตัวตน แสดงข้อความให้ลงคะแนน
lcd.clear();
lcd.print("Select Candidate"); if(multiMode) {
lcd.setCursor(0,1);
lcd.print("Choose up to ");
lcd.print(maxSelections);
}
Serial.println("Authentication successful, ready for voting.");

// 6. รับอินพุตการลงคะแนนจากปุ่ม
if(!multiMode) {
// --- โหมดเลือกได้คนเดียว ---
int chosenIndex = -1;
// รอจนกว่าจะมีการกดปุ่มใดปุ่มหนึ่ง
while(chosenIndex == -1) {
for(int i = 0; i < numCandidates; i++) { if(digitalRead(candidateButtons[i]) == LOW) { // ปุ่มถูกกด (เนื่องจากใช้ INPUT_PULLUP, LOW = กด)
chosenIndex = i;
// หน่วงรอจนปล่อยปุ่ม เพื่อ debounce
while(digitalRead(candidateButtons[i]) == LOW) { delay(10); } break;
}
}
}
// เพิมคะแนนให้ผู้สมัครที่เลือก ่
voteCounts[chosenIndex] += 1;
Serial.printf("Voted for candidate %d\n", chosenIndex+1); } else {
// --- โหมดเลือกได้หลายคน ---
bool selectedFlags[8] = {false};
int countSelected = 0;
// วนรับการกดจนกว่าจะครบจ;านวนที่ก;าหนด
while(countSelected < maxSelections) {
for(int i = 0; i < numCandidates; i++) { if(digitalRead(candidateButtons[i]) == LOW && !selectedFlags[i]) {
// หากปุ่ม i ถูกกดและยังไม่เคยถูกเลือกมาก่อน
selectedFlags[i] = true;
countSelected++;
voteCounts[i] += 1;
Serial.printf("Selected candidate %d\n", i+1);
// อัปเดต LCD แจ้งจ;านวนที่เลือกแล้ว
lcd.clear();
lcd.print("Selected #");
lcd.print(i+1);
lcd.setCursor(0,1);
lcd.print("Count: ");
lcd.print(countSelected);
lcd.print("/");
lcd.print(maxSelections);
// รอจนปล่อยปุ่ม
while(digitalRead(candidateButtons[i]) == LOW) { delay(10); } if(countSelected >= maxSelections) break;
}
}
}
}
// 7. ปรับสถานะว่าโหวตแล้ว
votersDB[voterIndex].hasVoted = true;

// 8. ส่งข้อมูลผลโหวตไปยัง Server ผ่าน Wi-Fi
if(WiFi.status() == WL_CONNECTED) { HTTPClient http;
// สร้าง URL ส;าหรับส่งค;าขอ (ส่งคะแนนทังหมดไปด้วย ้ | )
String url = String(serverURL) + "?";
for(int i = 0; i < numCandidates; i++) {
url += "c" + String(i+1) + "=" + String(voteCounts[i]); if(i < numCandidates-1) url += "&";
}
http.begin(url);
int httpCode = http.GET(); // ส่ง HTTP GET request if(httpCode == 200) {
Serial.println("Results updated to server.");
} else {
Serial.printf("Failed to send (HTTP %d)\n", httpCode); }
http.end();
}
// 9. พิมพ์ใบเสร็จยืนยัน (ถ้าเช่อมต่อเครื่องพิมพ์ไว้ ื | )
// *โค้ดตัวอย่าง:*
// Serial2.begin(19200); // เช่อมต่อเครื่องพิมพ์ที่ ื | Serial2 (ต้องทราบว่าต่อ TX, RX ขาไหน)
// Serial2.println("Vote recorded successfully!");
// Serial2.print("Voter ID: "); Serial2.println(votersDB[voterIndex].fingerId);
// Serial2.println("Thank you for voting.");
// Serial2.write(0x0C); // สังตัดกระดาษ ่ | (ขึ้นอยู่กับรุ่นเครื่องพิมพ์)

// 10. แจ้งบน LCD และเตรียมพร้อมส;าหรับคนถัดไป
lcd.clear();
lcd.print("Vote Recorded!"); delay(2000);
mfrc522.PICC_HaltA(); // จบการท;างานกับบัตรใบนี้
}
ค;ำอธิบำยโค้ด: โค้ดด้านบนเริมต้นด้วยการ ่ | include ไลบรารีต่าง ๆ ที่จ;าเป็น จากนันตั ้ งค่าขาอุปกรณ์และ ้
ตัวแปรต่าง ๆ ใน setup() เชน่ เริมต้น ่ | RFID, Wi-Fi, เซ็นเซอร์ลายนิ้วมือ และ LCD ใน loop() จะเข้าสู่
ขันตอนวนซ;้าที่คอยตรวจจับการทาบบัตร ้ | RFID (ถ้าไม่มีบัตรเข้ามาใหม่ก็วนรอไปเรื่อย ๆ) เมื่อได้ UID ของบัตร
แล้วจะเรียกฟังก์ชนั findVoterByUID() เพื่อค้นหาในฐานข้อมูล ถ้าไม่พบก็จะขึ้น “Unauthorized” บน
หน้าจอ LCD และยกเลิกกระบวนการ ถ้าพบก็จะตรวจสถานะ hasVoted เพื่อปองกันการโหวตซ;้า ้ | จากนันสั ้ ง่
ให้ผู้ใชสแกนลายนิ ้ | ้วมือ เปรียบเทียบกับ ID ที่ลงทะเบียนไว้ หากไม่ตรงก็ขึ้น “Fingerprint Err” แล้วจบ
กระบวนการ ถ้าตรงก็ไปยังขันตอนการลงคะแนนโดยให้กดปุ่มเลือกผู้สมัคร ้ | โค้ดได้แยกกรณี multiMode
เพื่อรองรับทังสองโหมดตามที่ระบุ ้ | เมื่อบันทึกตัวเลือกลงในตัวแปร voteCounts แล้ว ก็ท;าการส่งข้อมูล
ผ่าน Wi-Fi โดยในตัวอย่างใช้ HTTP GET ที่ใส่พารามิเตอร์คะแนนของผู้สมัครแต่ละคน (c1..c8) ส่งไปยัง URL
ของเซิร์ฟเวอร์จากนัน้ (ถ้ามีเครื่องพิมพ์) จะสังพิมพ์ใบเสร็จยืนยัน ่ | สุดท้ายแสดงผล "Vote Recorded!" ให้ผู้
ใชทราบและ ้ | reset การอ่านบัตร RFID เพื่อพร้อมรับคนถัดไป

กำรปรับใชบน้ Arduino UNO: หากใช้ Arduino UNO/MEGA แทน ESP32 ส่วนโค้ดหลักจะคล้ายกัน ยกเว้นการเช่อมต่อ ื Wi-Fi ที่ต้องพึ่งพาโมดูลภายนอก (เชน่ ESP8266) หรือการสื่อสารทางอนุกรมกับคอมพิวเตอร์แทน (Serial ผ่าน USB) รวมถึง การใชไลบรารี ้ WiFi ของ Arduino หากใช้ Arduino Uno WiFi. นอกจากนี้ Arduino UNO มีข้อจ;ากัดที่ Serial อย่างเดียว

อาจต้องใช้ SoftwareSerial (เชน่ ขา D2,D3) ส;าหรับเซ็นเซอร์ลายนิ้วมือ เพื่อไม่ให้ชนกับ Serial หลักที่ใชติดต่อกับ ้ คอมพิวเตอร์

## กำรส่งข้อมูลผ่ำน Wi-Fi และแดชบอร์ดแสดงผล

ในการส่งข้อมูลผลการลงคะแนนไปยังคอมพิวเตอร์แบบเรียลไทม์ เราสามารถเลือกใชวิธีการสื่อสารได้หลายรูปแบบ ้ | เชน่ HTTP,
WebSocket หรือ MQTT ส;าหรับโครงงานนี้จะยกตัวอย่างการใช้ HTTP Request เนื่องจากเข้าใจง่าย โดยหลังจากที่ไมโคร
คอนโทรลเลอร์ (ESP32) เช่อมต่อเข้าเครือข่าย ื | Wi-Fi เดียวกับเครื่องคอมพิวเตอร์แล้ว จะสามารถส่งค;าร้องขอ HTTP ไปยัง
เซร์ฟเวอร์เว็บ ิ | (Web Server) ที่รันอยู่บนเครื่องคอมฯ ได้
ฝั่งคอมพิวเตอร์เราสามารถเขียนโปรแกรมเซิร์ฟเวอร์อย่างง่ายเพื่อรับข้อมูลและแสดงผลได้ อาจเลือกใชภาษา ้ | Python (ผ่าน
เฟรมเวิร์ก Flask) หรือ Node.js (ผ่านเฟรมเวิร์ก Express หรือ Socket.io) ทังสองแบบสามารถท;าให้เกิดแดชบอร์ดแบบ ้
เรียลไทม์ได้ทังคู่ ในที่นี้ขอยกตัวอย่างด้วย ้ | Python Flask ซึ่งจะรับค่าคะแนนที่ ESP32 ส่งมาแล้วแสดงบนหน้าเว็บ
ขันตอนกำรตั ้ | ้งค่ำ: ให้เครื่องคอมพิวเตอร์ (หรือ ODROID) รันสคริปต์ Python เพื่อเป็นเซิร์ฟเวอร์รอรับข้อมูล ก่อนอื่นต้อง
ติดตัง ้ Flask (ด้วยค;าสัง ่ pip install flask ) จากนันใช ้ โค้ดดังต่อไปนี้ ้ | :

from flask import Flask, request

app = Flask(__name__)

# ตัวแปรเก็บคะแนนล่าสุดของผู้สมัคร (เริมต้น ่ 0 ทุกคน 8 คน)

vote_counts = [0]*8

@app.route('/update')
def update_results():
# ดึงค่าคะแนนจากพารามิเตอร์ URL (c1..c8)

global vote_counts
for i in range(1, 9):
param = request.args.get(f'c{i}')
if param is not None:
vote_counts[i-1] = int(param)
print("Updated counts:", vote_counts) # แสดงใน console (ตรวจสอบ) return "OK", 200

@app.route('/')
def dashboard():
# สร้างหน้า HTML แสดงผลคะแนนปัจจุบัน

html = "<h1>ผลการเลือกตัง ้ (เรียลไทม์)</h1><ul>"
for idx, count in enumerate(vote_counts, start=1): html += f"<li>ผู้สมัคร #{idx}: {count} votes</li>" html += "</ul>"
return html

if __name__ == "__main__":
# รันเซิร์ฟเวอร์ Flask บนโฮสต์เครื่อง (ให้ ESP32 ส่งเข้า IP เครื่องนี้)

app.run(host='0.0.0.0', port=5000)

โค้ดด้านบนสร้างเซิร์ฟเวอร์เว็บที่มีสองเส้นทาง (route) คือ /update ส;าหรับรับข้อมูลอัปเดตผลคะแนน และ / ส;าหรับ แสดงแดชบอร์ด ในฟังก์ชนั update_results() จะรับพารามิเตอร์ c1 ถึง c8 จาก URL (ซึ่ง ESP32 ส่งมา) แล้ว
อัปเดตค่าในอาเรย์ vote_counts จากนันส่งค;าตอบ ้ | “OK” กลับไป ส่วนฟังก์ชนั dashboard() จะสร้าง HTML อย่าง
ง่ายโดยแสดงรายช่อผู้สมัคร ื | (#1 ถึง #8) พร้อมจ;านวนคะแนนที่สะสมจนถึงล่าสุด
ในการใชงานจริง ้ | ให้รันสคริปต์นี้ ( python server.py ) บนเครื่องคอมพิวเตอร์ที่เช่อมเน็ตเวิร์กเดียวกับ ื | ESP32 แล้วเปิด
เว็บเบราว์เซอร์ไปที่ http://<IP_เครื่อง>:5000/ (เชน่ | http://192.168.1.100:5000/ ) จะเห็นหน้าเว็บ
รายงานผลคะแนนแบบเรียลไทม์ ซึ่งทุกครังที่มีการลงคะแนนใหม่และ ้ | ESP32 ส่งข้อมูลมายัง /update , ข้อมูลบนหน้าแด
ชบอร์ด (ถ้ารีเฟรชหน้าเว็บ) จะแสดงตัวเลขที่เปลี่ยนไปทันที
ในการท;าให้แดชบอร์ดอัปเดตแบบเรียลไทม์โดยไม่ต้องรีเฟรชหน้า อาจพัฒนาเพิมเติมโดยใช ่ | เทคนิค ้ | AJAX หรือ WebSocket
(เชน่ ใช้ Flask-SocketIO หรือใน Node.js ใช้ Socket.io) เพื่อ push ข้อมูลไปที่หน้าเว็บอัตโนมัติเมื่อมีการโหวตใหม่ อย่างไรก็ ตาม ในบริบทโครงงานนักศึกษานี้ การรีเฟรชหน้าเว็บหรือกดปุ่มแสดงผลใหม่หลังการลงคะแนนก็อาจเพียงพอแล้ว

หมำยเหตุ: หากเลือกใช้ Node.js สามารถเขียนเซิร์ฟเวอร์ด้วย Express ที่รับ req.query คล้าย ๆ กัน แล้วใช้ Socket.io ส่งข้อมูลไปยังหน้าเว็บ HTML ที่ท;าเป็นแดชบอร์ด ซึ่งจะท;าให้เห็นผลทันทีโดยไม่ต้องรีเฟรช ส่วนการท;า UI สามารถใช้HTML/JS สร้างเป็นกราฟหรือ bar chart ให้ดูเข้าใจง่ายขึ้น

ด้วยระบบเครือข่ายนี้ การสื่อสารข้อมูลผลโหวตจะเกิดขึ้นแบบเรียลไทม์จากเครื่องลงคะแนนไปยังศูนย์กลาง ซึ่งชวยเพิ ่ มความ ่ โปร่งใส ผู้เกี่ยวข้องสามารถติดตามจ;านวนคะแนนของผู้สมัครแต่ละคนได้ทันที ลดขันตอนการนับคะแนนด้วยมือและความ ้ ผิดพลาดที่อาจเกิดขึ้นได้ และหากต้องการขยายระบบให้รองรับหลายเครื่องลงคะแนน (หลายบูธ) ก็สามารถท;าได้โดยให้แต่ละ เครื่องส่งข้อมูลเข้ามายังเซิร์ฟเวอร์กลางเดียวกันเพื่อรวมคะแนน

## ฟังก์ชนกำรพิมพ์ใบเสร็จยืนยัน ั

หนึ่งในฟีเจอร์เพิมเติมของระบบนี้คือการพิมพ์ใบยืนยันการลงคะแนน ่ | (Vote receipt) เมื่อผู้ใชลงคะแนนส;าเร็จ ้ | โมดูลเครื่องพิมพ์
ความร้อนที่ใชในโครงงานสามารถเป็นรุ่นที่รองรับ ้ | TTL Serial (เชน่ เครื่องพิมพ์ความร้อนขนาดเล็กของ AdaFruit หรือยี่ห้ออื่น
ที่คล้ายกัน) ซึ่งมีขา TX, RX ส;าหรับรับส่งข้อมูลการพิมพ์วิธีการต่อคือใชขา ้ TX ของไมโครคอนโทรลเลอร์ต่อเข้า RX ของเครื่อง พิมพ์ (ส่วน TX ของเครื่องพิมพ์สามารถต่อกลับเข้าที่ RX ของ MCU เพื่อรับสถานะได้แต่ไม่จ;าเป็นส;าหรับงานนี้) พร้อมทังจ่ายไฟ ้ เลี้ยงให้เครื่องพิมพ์ (ส่วนใหญ่ใช 5V 2A) ้
ในการใชงานกับ ้ | Arduino/ESP32 สามารถใชไลบรารีเช ้ | น่ Adafruit Thermal Printer library เพื่อสะดวกในการพิมพ์
ข้อความและจัดรูปแบบ หรือจะส่งชุดค;าสัง่ ESC/POS โดยตรงก็ได้ในโค้ดตัวอย่างที่แสดงข้างต้น (ข้อ 9 ในโค้ด) มีการคอมเมนต์ ให้เห็นแนวทางการพิมพ์อย่างง่ายโดยใช้ Serial2 ส่งข้อความตัวอักษรไปยังเครื่องพิมพ์ (โดยต้องเปิด Serial2 ด้วย baud rate ที่ตรงกับเครื่อง เชน่ 19200 หรือ 9600 แล้วแต่รุ่น ) ตัวอย่างเชน่ :

Serial2.begin(19200);
Serial2.println("Vote recorded successfully!"); Serial2.println("Voter ID: 001"); Serial2.println("Thank you for voting.");
Serial2.write(0x0C); // ค;าสังตัดกระดาษ ่ | (ฟีดกระดาษและตัด)

เมื่อเครื่องพิมพ์ได้รับข้อความเหล่านี้ก็จะพิมพ์ออกมาตามบรรทัด ตัวอย่าง output ที่ได้บนกระดาษอาจเป็น:

10 (https://www.researchgate.net/publication/347968409_Arduino_Based_Authenticated_Voting_Machine_AVM_using_RFID_and_Fingerprint_for_the_Student_Elections)

11 (https://learn.adafruit.com/mini-thermal-receipt-printer/microcontroller) 12 (https://learn.adafruit.com/mini-thermal-receipt-printer/microcontroller#:~:text=Copy%20Code)

Vote recorded successfully! Voter ID: 001
Thank you for voting.
จากนันตัวค;าสั ้ | ง่ 0x0C (หรือค;าสังที่เครื่องพิมพ์แต่ละรุ่นก;าหนด ่ | ) จะสังให้เครื่องพิมพ์ตัดกระดาษอัตโนมัติ ่ | ผู้ลงคะแนนก็จะได้รับ
ใบเสร็จนี้ออกมาจากเครื่องเพื่อเก็บไว้เป็นหลักฐาน
ข้อควรระวัง: เครื่องพิมพ์ความร้อนใชกระแสค่อนข้างสูงช ้ | วงพิมพ์ ่ | (โดยเฉพาะตอนตัดกระดาษและเลื่อนกระดาษ) จึงควรใชแหล่ง ้
จ่าย 5V ที่จ่ายกระแสได้พอเพียง (เชน่ อะแดปเตอร์ 5V 2A) แยกต่างหาก ไม่ดึงไฟจากบอร์ดไมโครคอนโทรลเลอร์โดยตรง เพื่อ ปองกันปัญหาแรงดันตกหรือรีเซ็ตเครื่องไมโครคอนโทรลเลอร์ ้
การพิมพ์ใบเสร็จนี้เป็นเพียงตัวเลือกเสริม แต่มีประโยชน์ในการเสริมความน่าเช่อถือของระบบ ื | ถ้าน;าระบบนี้ไปใชในการเลือกตั ้ | งจริง ้
(เชน่ การเลือกตังสโมสรกีฬาหรือองค์การนักศึกษา ้ | ) ใบเสร็จเหล่านี้สามารถใชในการตรวจสอบภายหลังได้ว่าสิทธิ ้ | ของแต่ละคนถูก ์
ใชอย่างถูกต้องหรือไม่ ้ | อย่างไรก็ตาม ควรค;านึงถึงความลับในการลงคะแนนด้วย จึงไม่ควรพิมพ์รายละเอียดว่าโหวตให้ใคร ควร
พิมพ์เพียงว่าผู้ใช้ID ใดได้ลงคะแนนแล้ว เวลาใด เป็นต้น

## กำรติดตั้งและโครงสร้ำงทำงกำยภำพ

ในส่วนของโครงสร้างตู้ลงคะแนน สามารถสร้างขึ้นจากวัสดุที่หาได้ง่าย เชน่ กล่องกระดาษลัง แผ่นโฟมกระดาน หรืออะคริลิก ตาม ความคิดสร้างสรรค์ของผู้จัดท;า แนวคิดคือท;าเป็นลักษณะคูหาลงคะแนนขนาดย่อมที่มีฝาปิดบางส่วนเพื่อความเป็นส่วนตัว โดยมี องค์ประกอบดังนี้:

แผงด้ำนหน้ำส;ำหรับผู้ใช:้ เจาะชองส;าหรับหน้าจอ ่ | LCD ให้อยู่ในระดับสายตา และเจาะรูขนาดพอเหมาะส;าหรับติดตัง้
เซ็นเซอร์ลายนิ้วมือ (ควรยึดโมดูลลายนิ้วมือจากด้านในให้ผิวหน้าของเซ็นเซอร์เสมอกับผิวกล่อง), ติดตังเครื่องอ่าน ้ RFID (โดยอาจน;าแท็ก RFID มาแตะที่ด้านนอกกล่องในบริเวณที่มีเครื่องอ่านอยู่ภายใน เนื่องจากคลื่น RFID ทะลุวัสดุ
บางได้ หรือเจาะชองและติดเครื่องอ่านโผล่ออกมาด้านนอกเลยก็ได้ ่ | )
แผงปุ่มกด: จัดวางปุ่มกดหมายเลขผู้สมัคร 1–8 เรียงตามล;าดับ อาจตีตารางหรือพิมพ์สติ๊กเกอร์หมายเลขก;ากับไว้
ชดเจน ขนาดปุ่มควรใหญ่พอที่กดง่าย เว้นระยะห่างพอประมาณเพื่อไม่ให้กดผิด ผู้ใช ั | จะเลือกกดปุ่มเหล่านี้ตามผู้สมัครที่ ้
| ต้องการโหวต
ไฟแสดงสถำนะ (ถ้ำม):ี อาจติด LED สีแดง/เขียวบนแผงเพื่อแสดงสถานะ “พร้อมใชงาน ้ ” หรือ “ตรวจสอบผ่าน” เป็นต้น เชน ่ LED เขียวสว่างเมื่อลายนิ้วมือผ่านการยืนยัน และ LED แดงกระพริบเมื่อเกิดข้อผิดพลาด
ต;ำแหน่งเครื่องพิมพ์ (ถ้ำม):ี เครื่องพิมพ์ความร้อนสามารถติดตังไว้ด้านข้างหรือด้านหน้าล่างของตู้ โดยเจาะช ้ | อง่
ส;าหรับให้กระดาษใบเสร็จเลื่อนออกมาได้สะดวก หลังเครื่องพิมพ์ควรเผื่อชองให้สามารถเปลี่ยนม้วนกระดาษได้ง่าย ่
| กำรจัดวำงภำยใน: ติดตังบอร์ดไมโครคอนโทรลเลอร์บนแผ่นกระดานหรือพลาสติกภายในกล่องยึดให้แน่นหนา วาง ้
โมดูล RFID และสายอากาศในต;าแหน่งที่ใกล้กับจุดที่ผู้ใชจะแตะบัตร ้ | (เพื่อให้อ่านบัตรได้ง่าย สัญญาณไม่ถูกบัง) เดินสาย
| ไฟและสายสัญญาณต่าง ๆ ให้เป็นระเบียบ ใชที่รัดสายหรือเทปพันสายยึดเพื่อลดความยุ่งเหยิง ้
| แหล่งจ่ำยไฟ: หากใชแบตเตอรี่หรือ ้ | Power Bank ควรวางไว้ในกล่องด้วยและท;าชองส;าหรับชาร์จ หรือถ้าใช ่ | หม้อแปลง ้
| AC->DC ต่อเข้ากับปลักไฟ ให้ท;ารูให้สายไฟออกจากตัวกล่องได้อย่างปลอดภัย ไม่เกะกะทางเดิน ๊
เมื่อประกอบทุกส่วนเข้าด้วยกัน จะได้ตู้ลงคะแนนเสียงอัจฉริยะที่มีลักษณะคล้ายเครื่องลงคะแนนอิเล็กทรอนิกส์ขนาดเล็ก ผู้ใชงาน ้
จะเห็นหน้าจอข้อความ เห็นชองให้สแกนบัตรและลายนิ ่ | ้วมือ และมีปุ่มเลือกผู้สมัครให้กดชดเจน ั | ตัวอย่างรูปลักษณ์อาจคล้ายตู้
EVM ของงานประกวดโครงงานที่ท;าจากวัสดุเรียบง่ายแต่ฟังก์ชนครบถ้วน ั
การออกแบบโครงสร้าง DIY เชนนี้ช ่ วยลดต้นทุนและสามารถปรับแต่งรูปทรง ่ | สีสัน ได้ตามต้องการ แต่ผู้จัดท;าต้องค;านึงถึงความ
แข็งแรงในการใชงานจริงด้วย ้ | (เชน่ ปุ่มกดต้องติดแน่น, โมดูลต่าง ๆ ไม่โยกหรือหลุดง่าย) รวมถึงความปลอดภัย (ไม่มีสายไฟ
เปลือยหรือจุดที่ผู้ใชจะโดนกระแส ้ | /บาดเจ็บ) เพื่อให้การสาธิตเป็นไปอย่างราบรื่นและมืออาชพี

•

•

•

•

•

•

## สรุปกำรท;ำงำนของระบบ

เครื่องลงคะแนนเสียงอัจฉริยะด้วย Arduino/ESP32 นี้รวมข้อดีของระบบลงคะแนนอิเล็กทรอนิกส์เข้ากับมาตรการรักษาความ
ปลอดภัยแบบสองชนั้ ผลที่ได้คือระบบที่ผู้มีสิทธิต้องยืนยันตัวตนด้วย ์ | บางสิ่งที่พวกเขามี (บัตร RFID) และ บางสิ่งที่พวกเขาเป็น
(ลายนิ้วมือ) ก่อนจะลงคะแนนเสียง ซึ่งชวยป ่ องกันการสวมสิทธิ ้ | และการลงคะแนนซ;้าได้อย่างมีประสิทธิภาพ ์ | หลังการยืนยัน
ระบบจะให้ผู้ใชลงคะแนนผ่านอินเทอร์เฟซที่เรียบง่าย ้ | (ปุ่มกดหมายเลขผู้สมัคร) ซึ่งผลลัพธ์จะถูกส่งไปนับรวมและแสดงผลแบบ
เรียลไทม์ท;าให้ผู้จัดการเลือกตังสามารถติดตามความคืบหน้าของการลงคะแนนได้ทันทีโดยไม่ต้องรอนับมือ ้ | นอกจากนี้การพิมพ์
ใบเสร็จยืนยันยังเพิมความโปร่งใส เพราะผู้ลงคะแนนสามารถตรวจสอบได้ว่าเสียงของตนถูกบันทึกแล้วจริงๆ ่
ระบบนี้ถูกออกแบบมาให้ใกล้เคียงการใชงานจริงในระดับหนึ่ง ้ | แต่ยังคงความง่ายในการสร้างส;าหรับนักศึกษา โดยใชอุปกรณ์ที่มี ้
จ;าหน่ายทัวไปและซอฟต์แวร์โอเพนซอร์ส ่ | การประกอบลงในตู้กระดาษลัง DIY ชวยให้ต้นทุนต;่าและน;าเสนอแนวคิดได้ดี ่ | อย่างไรก็
ตาม หากจะน;าไปต่อยอดเป็นระบบลงคะแนนจริงที่ใชในวงกว้าง ้ | อาจต้องพัฒนาเพิมเติมในหลายด้าน ่ | เชน่ การเข้ารหัสข้อมูลเมื่อ
ส่งผ่านเครือข่าย, การปองกันการงัดแงะเครื่อง ้ | (tamper-proof), การส;ารองข้อมูลคะแนนลงหน่วยความจ;าถาวร, หรือการ
รองรับจ;านวนผู้มีสิทธิและผู้สมัครที่มากขึ้น เป็นต้น ์

โดยสรุป เครื่องลงคะแนนเสียงอัจฉริยะนี้แสดงถึงการผสมผสานฮาร์ดแวร์และซอฟต์แวร์เพื่อแก้ปัญหาของระบบลงคะแนนแบบ
เดิม ไม่ว่าจะเป็นการปองกันการโกงคะแนนหรือการนับคะแนนที่ล่าช ้ | า้ ระบบนี้เน้นที่ความถูกต้อง แม่นย;า และความโปร่งใส ซึ่งเป็น
หัวใจส;าคัญของการเลือกตังในทุกระดับ ้ | แม้จะเป็นต้นแบบส;าหรับโครงงานนักศึกษา แต่แนวคิดและเทคโนโลยีที่ใชก็สามารถ ้
ต่อยอดไปสู่ระบบ E-Voting ที่ใชงานจริงได้ในอนาคต หากได้รับการพัฒนาเพิ ้ | มเติมอย่างเหมาะสม ่

แหล่งอ้ำงอิง:

Arduino Based Authenticated Voting Machine (AVM) using RFID and Fingerprint for the Student Elections
Fingerprint Based Biometric Voting Machine using Arduino – CircuitDigest
Fingerprint & RFID Based Voting Machine – IEEE Maker Project
A Proposed Framework for Fingerprint-based Voting System – ResearchGate ESP32 with MFRC522 RFID Reader – Random Nerd Tutorials
RFID & Fingerprint Advanced Security System – electroniclinic.com
Arduino Code for Thermal Printer – Adafruit
Other references and resources on electronic voting machine design and IoT connectivity

(PDF) Arduino Based Authenticated Voting Machine (AVM) using RFID and Fingerprint for the Student Elections
https://www.researchgate.net/publication/347968409_Arduino_Based_Authenticated_Voting_Machine_AVM_using_RFID_and_Fingerprint_for_the_Student_Elections (https://www.researchgate.net/publication/347968409_Arduino_Based_Authenticated_Voting_Machine_AVM_using_RFID_and_Fingerprint_for_the_Student_Elections)
ESP32 with MFRC522 RFID Reader/Writer (Arduino IDE) | Random Nerd Tutorials
https://randomnerdtutorials.com/esp32-mfrc522-rfid-reader-arduino/
RFID & Fingerprint based Advanced Security System using Arduino
https://www.electroniclinic.com/rfid-fingerprint-based-advanced-security-system-using-arduino/
Fingerprint Based Biometric Voting Machine Project using Arduino
https://circuitdigest.com/microcontroller-projects/fingerprint-based-biometric-voting-machine-arduino
Fingerprint & RFID Based Voting Machine - The IEEE Maker Project
https://transmitter.ieee.org/makerproject/view/01ccd
Arduino Code | Mini Thermal Receipt Printers | Adafruit Learning System
https://learn.adafruit.com/mini-thermal-receipt-printer/microcontroller

1 (https://www.researchgate.net/publication/347968409_Arduino_Based_Authenticated_Voting_Machine_AVM_using_RFID_and_Fingerprint_for_the_Student_Elections)

10 (https://www.researchgate.net/publication/347968409_Arduino_Based_Authenticated_Voting_Machine_AVM_using_RFID_and_Fingerprint_for_the_Student_Elections)

1.

1 (https://www.researchgate.net/publication/347968409_Arduino_Based_Authenticated_Voting_Machine_AVM_using_RFID_and_Fingerprint_for_the_Student_Elections) | 9 (https://www.researchgate.net/publication/347968409_Arduino_Based_Authenticated_Voting_Machine_AVM_using_RFID_and_Fingerprint_for_the_Student_Elections)
2. | 13 (https://circuitdigest.com/microcontroller-projects/fingerprint-based-biometric-voting-machine-arduino) | 6 (https://circuitdigest.com/microcontroller-projects/fingerprint-based-biometric-voting-machine-arduino)
3. 7 (https://transmitter.ieee.org/makerproject/view/01ccd)
4. 2 (https://www.researchgate.net/publication/347968409_Arduino_Based_Authenticated_Voting_Machine_AVM_using_RFID_and_Fingerprint_for_the_Student_Elections)
5. 4 (https://randomnerdtutorials.com/esp32-mfrc522-rfid-reader-arduino/)
6. | 5 (https://www.electroniclinic.com/rfid-fingerprint-based-advanced-security-system-using-arduino/) | 14 (https://www.electroniclinic.com/rfid-fingerprint-based-advanced-security-system-using-arduino/)
7. | 11 (https://learn.adafruit.com/mini-thermal-receipt-printer/microcontroller) | 12 (https://learn.adafruit.com/mini-thermal-receipt-printer/microcontroller#:~:text=Copy%20Code)
8. | 10 (https://www.researchgate.net/publication/347968409_Arduino_Based_Authenticated_Voting_Machine_AVM_using_RFID_and_Fingerprint_for_the_Student_Elections) | 15 (https://www.researchgate.net/publication/347968409_Arduino_Based_Authenticated_Voting_Machine_AVM_using_RFID_and_Fingerprint_for_the_Student_Elections)
1 (https://www.researchgate.net/publication/347968409_Arduino_Based_Authenticated_Voting_Machine_AVM_using_RFID_and_Fingerprint_for_the_Student_Elections) | 2 (https://www.researchgate.net/publication/347968409_Arduino_Based_Authenticated_Voting_Machine_AVM_using_RFID_and_Fingerprint_for_the_Student_Elections) | 3 (https://www.researchgate.net/publication/347968409_Arduino_Based_Authenticated_Voting_Machine_AVM_using_RFID_and_Fingerprint_for_the_Student_Elections) | 8 (https://www.researchgate.net/publication/347968409_Arduino_Based_Authenticated_Voting_Machine_AVM_using_RFID_and_Fingerprint_for_the_Student_Elections) | 9 (https://www.researchgate.net/publication/347968409_Arduino_Based_Authenticated_Voting_Machine_AVM_using_RFID_and_Fingerprint_for_the_Student_Elections) | 10 (https://www.researchgate.net/publication/347968409_Arduino_Based_Authenticated_Voting_Machine_AVM_using_RFID_and_Fingerprint_for_the_Student_Elections) | 15 (https://www.researchgate.net/publication/347968409_Arduino_Based_Authenticated_Voting_Machine_AVM_using_RFID_and_Fingerprint_for_the_Student_Elections)

4 (https://randomnerdtutorials.com/esp32-mfrc522-rfid-reader-arduino/)

5 (https://www.electroniclinic.com/rfid-fingerprint-based-advanced-security-system-using-arduino/) | 14 (https://www.electroniclinic.com/rfid-fingerprint-based-advanced-security-system-using-arduino/)
6 (https://circuitdigest.com/microcontroller-projects/fingerprint-based-biometric-voting-machine-arduino) | 13 (https://circuitdigest.com/microcontroller-projects/fingerprint-based-biometric-voting-machine-arduino)

7 (https://transmitter.ieee.org/makerproject/view/01ccd)

11 (https://learn.adafruit.com/mini-thermal-receipt-printer/microcontroller) 12 (https://learn.adafruit.com/mini-thermal-receipt-printer/microcontroller#:~:text=Copy%20Code)
