patt502090/smart-voting-machine/Odroid_Project/ai_webcam/CoE/CoE-Eng.png

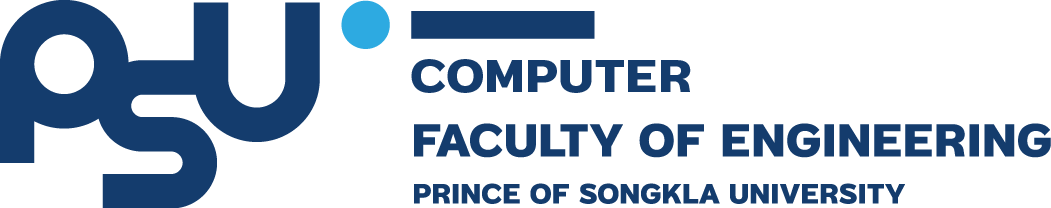
Odroid_Project/ai_webcam/CoE/CoE-Eng.png
