patt502090/smart-voting-machine/temp/Patt/asset/9.jpg

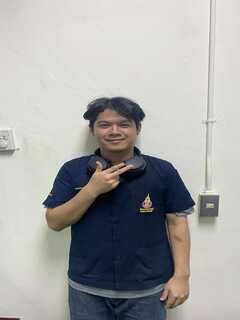
temp/Patt/asset/9.jpg
