patt502090/smart-voting-machine/temp/Patt/esp32/data/img/1.jpg

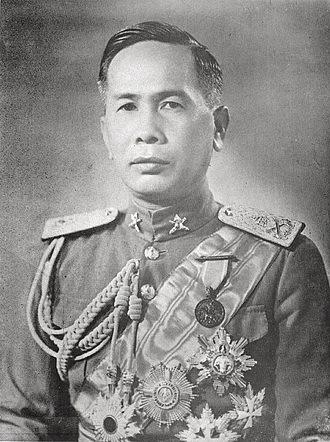
temp/Patt/esp32/data/img/1.jpg
