patt502090/smart-voting-machine/temp/Patt/esp32/resize/0.jpg

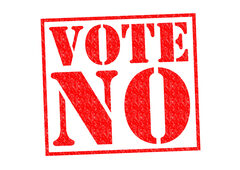
temp/Patt/esp32/resize/0.jpg
