patt502090/smart-voting-machine/temp/Patt/esp32/resize/new/c101c8c46c8f44316963b95b956fb294b7d9b024f4f51625f33c6b0ab45b1ee3.png

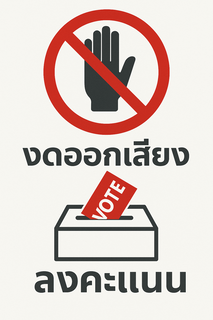
temp/Patt/esp32/resize/new/c101c8c46c8f44316963b95b956fb294b7d9b024f4f51625f33c6b0ab45b1ee3.png
