patt502090/smart-voting-machine/temp/Patt/image.png

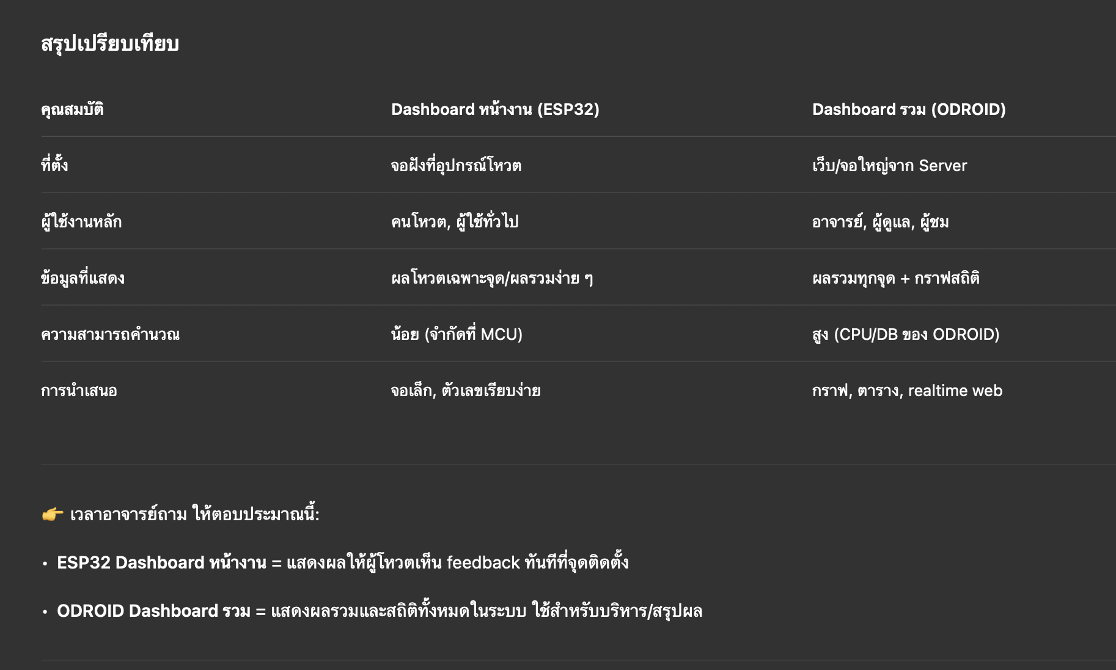
temp/Patt/image.png
