patt502090/smart-voting-machine/temp/Patt/work/img(jpg)/2.jpg

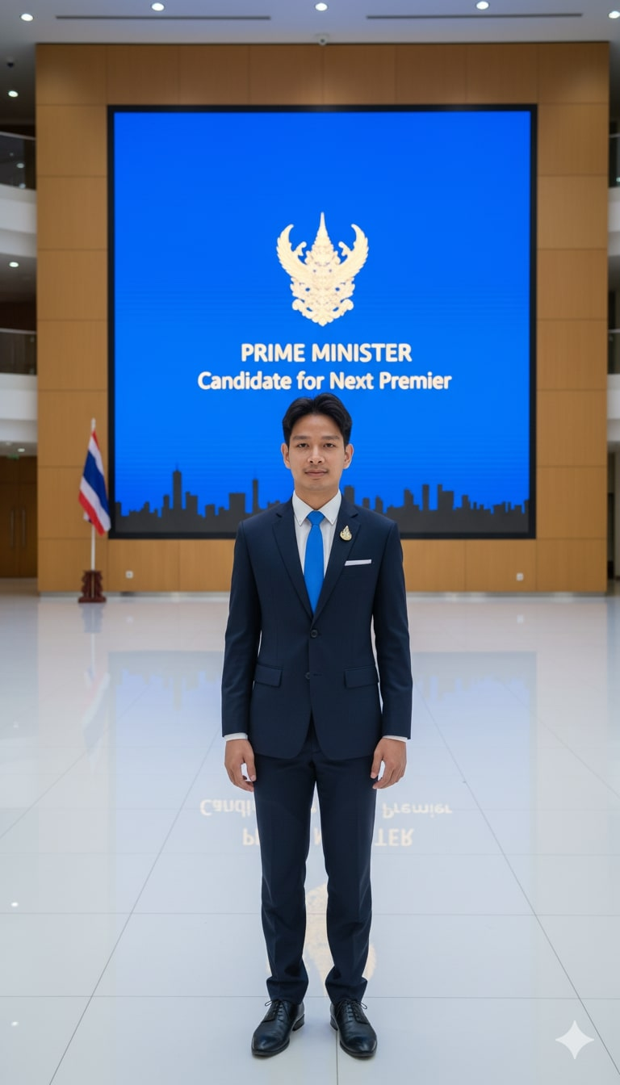
temp/Patt/work/img(jpg)/2.jpg
