patt502090/smart-voting-machine/temp/Patt/work/img(jpg)/3.jpg

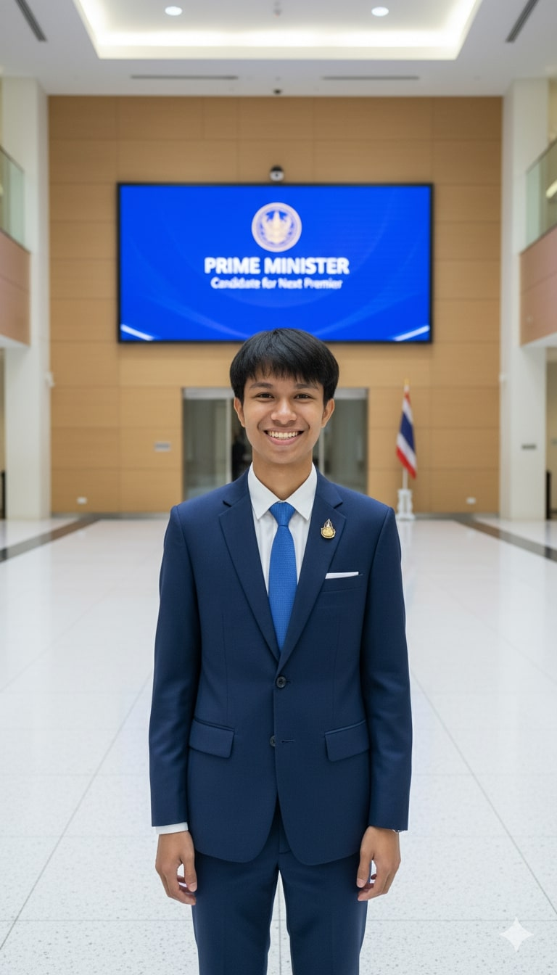
temp/Patt/work/img(jpg)/3.jpg
