patt502090/smart-voting-machine/temp/Patt/work/img(jpg)/4.jpg

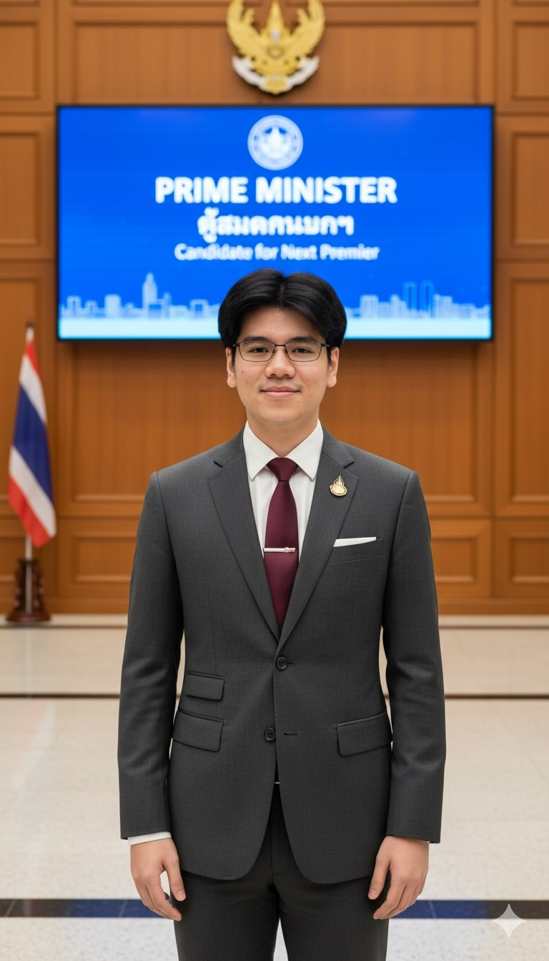
temp/Patt/work/img(jpg)/4.jpg
