patt502090/smart-voting-machine/temp/Patt/work/img(jpg)/8.jpg

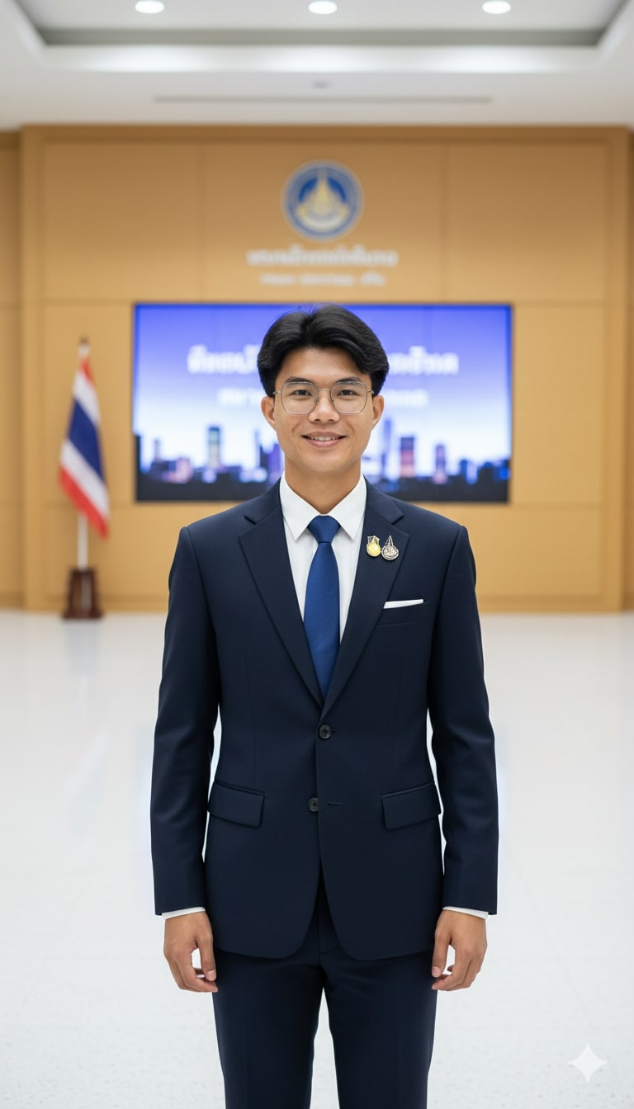
temp/Patt/work/img(jpg)/8.jpg
