patt502090/smart-voting-machine/temp/Patt/work/img(png)/Gemini_Generated_Image_m4evapm4evapm4ev.png

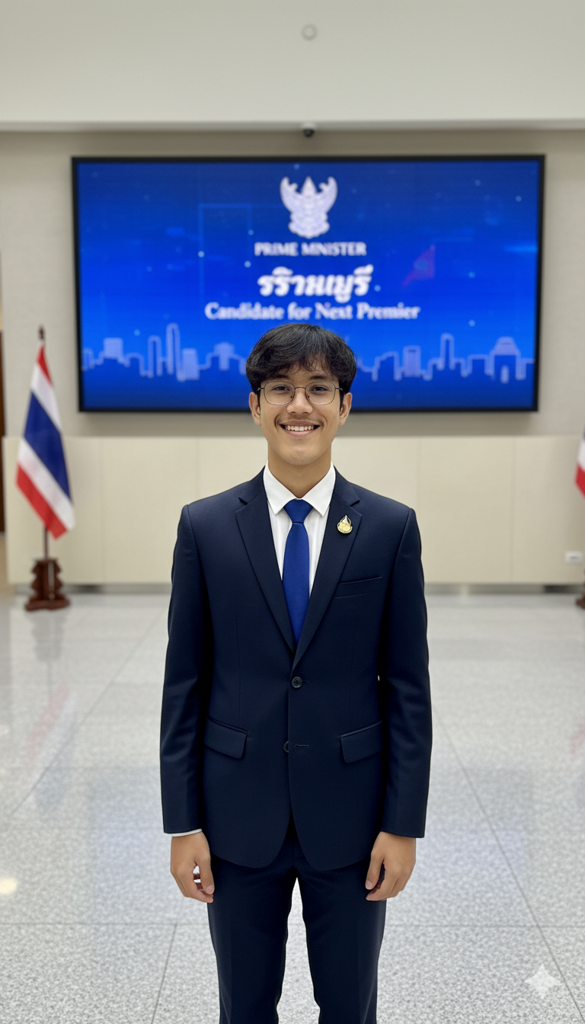
temp/Patt/work/img(png)/Gemini_Generated_Image_m4evapm4evapm4ev.png
