patt502090/smart-voting-machine/temp/Patt/work/resize/Gemini_Generated_Image_pvlli6pvlli6pvll (1).jpg

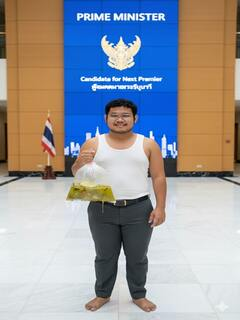
temp/Patt/work/resize/Gemini_Generated_Image_pvlli6pvlli6pvll (1).jpg
