patt502090/smart-voting-machine/temp/Patt/finally/arduinof/arduinock.ino

/*
  UNO + LCD 20x4 I2C (HW-061) + Keypad 4x4 via PCF8574 (I2C) + Buzzer "Arcade" SFX
  - 0..9 เลือก, '*'=ล้าง (เสียงลง), '#'=ยืนยัน (แฟนแฟร์ 4 โน้ต)
  - A/B/C/D = คลิกโทนสูง
  - ยืนยันแล้วส่ง "CF:X" ทาง Serial (ไป ESP32/PC)

  Wiring:
    I2C: A4=SDA, A5=SCL → LCD(0x27/0x3F) + PCF8574(keypad=0x20)
    Buzzer (2 ขา):
      Passive piezo: + → D5 (ผ่าน R 100–220Ω แนะนำ), − → GND
      Active buzzer : + → D5 (ตั้ง BUZZER_PASSIVE เป็น 0),       − → GND
    Speaker (TMRpcm): D9 → ขา + ของลำโพง (มี R 100–220Ω), − → GND
    SD: CS=4 (ตามบอร์ด SD card module)
*/

#include <Wire.h>
#include <LiquidCrystal_I2C.h>
#include <Keypad.h>
#include <Keypad_I2C.h>
#include <TMRpcm.h>
#include <SPI.h>
#include <SD.h>
#include <avr/wdt.h>
#include <TM1638plus.h>

#define STB A0
#define CLK A1
#define DIO A2

TM1638plus tm(STB, CLK, DIO, false); // ต้องใส่ bool argument

#define ESP_INT_PIN 3 // INT1 (D3) จาก ESP32

#include <avr/power.h>
#include <avr/sleep.h>
#include <avr/interrupt.h>

// ==== [ADD] RTC + กำหนดเวลาการเลือกตั้ง ====
#include <RTClib.h>
RTC_DS1307 rtc;

enum ElecState
{
    PREOPEN,
    OPEN,
    CLOSED
};
ElecState eState = PREOPEN, lastEState = (ElecState)255;

struct ElecWindow
{
    // ตั้ง "วัน/เวลาเริ่ม" และ "สิ้นสุด" ที่นี่ (แก้ให้ตรงกับงานจริง)
    // ตัวอย่าง: เริ่ม 09:00–16:00 วันที่ 2025-01-15
    DateTime start = DateTime(2025, 1, 15, 9, 0, 0);
    DateTime end = DateTime(2025, 1, 15, 16, 0, 0);
} EWIN;

unsigned long lastRTCpoll = 0;
const unsigned long RTC_POLL_MS = 500; // อัปเดตทุก 0.5s

// ข้อความสั้น ๆ ขึ้น TM1638 (8 ตัว)
const char *TXT_PRE = "PREOPEN";
const char *TXT_OPEN = "OPEN   ";
const char *TXT_END = "CLOSED ";

// --- Sleep/Idle policy ---
#define IDLE_SLEEP_MS 60000UL // ว่าง 60s -> หลับลึก
unsigned long lastActivityMs = 0;

// ===== SD / Audio =====
#define SD_ChipSelectPin 4
TMRpcm tmrpcm;

// ===== BUZZER CONFIG =====
#define BUZZER_PIN 5     // D5
#define BUZZER_PASSIVE 1 // 1=Passive piezo (tone/noTone), 0=Active buzzer (on/off)

// ===== I2C addresses =====
#define LCD_ADDR 0x27
#define KEYPAD_ADDR 0x20

LiquidCrystal_I2C lcd(LCD_ADDR, 20, 4);

// ===== Keypad map 4x4 =====
const byte ROWS = 4, COLS = 4;
char keys[ROWS][COLS] = {
    {'1', '2', '3', 'A'},
    {'4', '5', '6', 'B'},
    {'7', '8', '9', 'C'},
    {'*', '0', '#', 'D'}};
byte rowPins[ROWS] = {0, 1, 2, 3}; // PCF8574 P0..P3 = ROW0..ROW3
byte colPins[COLS] = {4, 5, 6, 7}; // PCF8574 P4..P7 = COL0..COL3
Keypad_I2C kpd(makeKeymap(keys), rowPins, colPins, ROWS, COLS, KEYPAD_ADDR);

// ===== State/UI =====
enum Page
{
    PAGE_WAIT,
    PAGE_VOTE,
    PAGE_CONFIRM,
    PAGE_REG_PASS
};
Page page = PAGE_WAIT;
bool canVote = false; // จะเป็น true ก็ต่อเมื่อได้รับ 'O' จาก ESP32

int currentChoice = -1;         // -1=ยังไม่เลือก, 0=งด, 1..9=ผู้สมัคร
unsigned long confirmUntil = 0; // แสดงหน้า Confirm แบบ non-blocking

// ===== Timers =====
const unsigned long interval = 100; // 5 วินาที กันสั่งเล่นถี่เกิน
unsigned long lastPlayTime = 0;
unsigned long lastPlayTime1 = 0;
unsigned long lastPlayTime2 = 0;
unsigned long lastPlayTime3 = 0;
unsigned long lastPlayTime4 = 0;
unsigned long lastPlayTime5 = 0;
unsigned long lastPlayTime6 = 0;
unsigned long lastPlayTime7 = 0;

volatile bool wokeFromEsp = false;
void isrEsp()
{
    wokeFromEsp = true;
}

void goSleepPowerDown()
{
    set_sleep_mode(SLEEP_MODE_PWR_DOWN);
    sleep_enable();

    noInterrupts();
    EIFR = bit(INTF1); // เคลียร์ธง INT1
#if defined(BODS) && defined(BODSE)
    MCUCR |= _BV(BODS) | _BV(BODSE);
    MCUCR = (MCUCR & ~_BV(BODSE)) | _BV(BODS);
#endif
    interrupts();

    sleep_cpu(); // หลับจริง

    // ====== ตื่นแล้ว ======
    sleep_disable();
}

// ===== CGRAM icons =====
byte I_TL[8] = {B11100, B10000, B10000, B10000, B10000, B10000, B10000, B10000};
byte I_TR[8] = {B00111, B00001, B00001, B00001, B00001, B00001, B00001, B00001};
byte I_BL[8] = {B10000, B10000, B10000, B10000, B10000, B10000, B10000, B11100};
byte I_BR[8] = {B00001, B00001, B00001, B00001, B00001, B00001, B00001, B00111};
byte I_H[8] = {B11111, B00000, B00000, B00000, B00000, B00000, B00000, B11111};
byte I_V[8] = {B10001, B10001, B10001, B10001, B10001, B10001, B10001, B10001};
byte I_AR[8] = {B00100, B00110, B00111, B11111, B00111, B00110, B00100, B00000};  // ▶
byte I_CHK[8] = {B00000, B00001, B00011, B10110, B11100, B01000, B00000, B00000}; // ✓

void loadIcons()
{
    lcd.createChar(0, I_TL);
    lcd.createChar(1, I_TR);
    lcd.createChar(2, I_BL);
    lcd.createChar(3, I_BR);
    lcd.createChar(4, I_H);
    lcd.createChar(5, I_V);
    lcd.createChar(6, I_AR);
    lcd.createChar(7, I_CHK);
}

void drawFrame()
{
    lcd.clear();
    // มุม
    lcd.setCursor(0, 0);
    lcd.write((byte)0);
    lcd.setCursor(19, 0);
    lcd.write((byte)1);
    lcd.setCursor(0, 3);
    lcd.write((byte)2);
    lcd.setCursor(19, 3);
    lcd.write((byte)3);
    // ขอบบน/ล่าง
    for (int x = 1; x < 19; x++)
    {
        lcd.setCursor(x, 0);
        lcd.write((byte)4);
        lcd.setCursor(x, 3);
        lcd.write((byte)4);
    }
    // ขอบซ้าย/ขวา
    for (int y = 1; y < 3; y++)
    {
        lcd.setCursor(0, y);
        lcd.write((byte)5);
        lcd.setCursor(19, y);
        lcd.write((byte)5);
    }
}

// ===== UI positions =====
const uint8_t POS_SPINNER_X = 18, POS_SPINNER_Y = 0; // มุมขวาบน
const uint8_t POS_ARROW_X = 1, POS_ARROW_Y = 2;      // ▶
const uint8_t POS_HINT_X = 2, POS_HINT_Y = 2;        // "#=Confirm  *=Clear"
const uint8_t POS_TITLE_X = 2, POS_TITLE_Y = 1;      // "Select:"
const uint8_t BOX_LEFT_X = 10;                       // กล่องเลข [n]
const uint8_t BOX_TOP_Y = 0;

// ===== Anim (non-blocking) =====
const char spinFrames[4] = {'|', '/', '-', '\\'};
uint8_t spinIdx = 0;
unsigned long lastSpinMs = 0;
const unsigned long SPIN_MS = 160;

bool boxOn = true;
unsigned long lastBlinkMs = 0;
const unsigned long BLINK_MS = 380;

// ===== Ready (wait auth) UI =====
uint8_t readyDots = 0;
unsigned long lastReadyMs = 0;
const unsigned long READY_MS = 350;

void drawChoiceBox(bool show)
{
    // เคลียร์พื้นที่ 10..14 x 0..2 ก่อน
    for (uint8_t y = 0; y <= 2; y++)
    {
        lcd.setCursor(BOX_LEFT_X, BOX_TOP_Y + y);
        lcd.print(F("     "));
    }
    if (currentChoice <= 0)
    { // 0=งด → "00"
        lcd.setCursor(12, 1);
        if (show)
            lcd.print(F("00"));
        else
            lcd.print(F("  "));
        return;
    }
    if (show)
    {
        // วาดกรอบ
        lcd.setCursor(10, 0);
        lcd.write((byte)0);
        for (int x = 11; x <= 13; x++)
        {
            lcd.setCursor(x, 0);
            lcd.write((byte)4);
        }
        lcd.setCursor(14, 0);
        lcd.write((byte)1);
        lcd.setCursor(10, 1);
        lcd.write((byte)5);
        lcd.setCursor(14, 1);
        lcd.write((byte)5);
        lcd.setCursor(10, 2);
        lcd.write((byte)2);
        for (int x = 11; x <= 13; x++)
        {
            lcd.setCursor(x, 2);
            lcd.write((byte)4);
        }
        lcd.setCursor(14, 2);
        lcd.write((byte)3);
        // ตัวเลขกลางกล่อง
        lcd.setCursor(12, 1);
        lcd.print(currentChoice);
    }
    else
    {
        // โชว์เฉพาะตัวเลข
        lcd.setCursor(12, 1);
        lcd.print(currentChoice);
    }
}

void drawVoteUI_base()
{
    loadIcons();
    drawFrame();
    // หัวข้อ + arrow + hint
    lcd.setCursor(POS_TITLE_X, POS_TITLE_Y);
    lcd.print(F("Select: 0=Abstain"));
    lcd.setCursor(POS_ARROW_X, POS_ARROW_Y);
    lcd.write((byte)6); // ▶
    lcd.setCursor(POS_HINT_X, POS_HINT_Y);
    lcd.print(F("#=Confirm  *=Clear"));

    // เคอร์เซอร์กระพริบตรงบรรทัดคำสั่ง
    lcd.setCursor(POS_HINT_X, POS_HINT_Y);
    lcd.blink();

    // ข้อความสถานะ
    if (currentChoice < 0)
    {
        lcd.setCursor(2, 0);
        lcd.print(F("Choose 1..9     "));
    }
    else if (currentChoice == 0)
    {
        lcd.setCursor(2, 0);
        lcd.print(F("Choice: Abstain "));
    }
    else
    {
        lcd.setCursor(2, 0);
        lcd.print(F("Choice:         "));
    }
    drawChoiceBox(currentChoice >= 0);

    // รีเซ็ตอนิเมชัน
    spinIdx = 0;
    lastSpinMs = millis();
    boxOn = true;
    lastBlinkMs = millis();
    lcd.setCursor(POS_SPINNER_X, POS_SPINNER_Y);
    lcd.print(spinFrames[spinIdx]);
}

void animateDuringSelect()
{
    unsigned long now = millis();
    // spinner
    if (now - lastSpinMs >= SPIN_MS)
    {
        lastSpinMs = now;
        spinIdx = (spinIdx + 1) & 0x03;
        lcd.setCursor(POS_SPINNER_X, POS_SPINNER_Y);
        lcd.print(spinFrames[spinIdx]);
    }
    // blink กล่องเลข
    if (currentChoice >= 0 && now - lastBlinkMs >= BLINK_MS)
    {
        lastBlinkMs = now;
        boxOn = !boxOn;
        drawChoiceBox(boxOn);
    }
}

// ---------- READY UI ----------
void drawReadyUI_base()
{
    loadIcons();
    drawFrame();
    lcd.noBlink();

    // สปินเนอร์มุมขวาบน
    spinIdx = 0;
    lastSpinMs = millis();
    lcd.setCursor(POS_SPINNER_X, POS_SPINNER_Y);
    lcd.print(spinFrames[spinIdx]);

    // ข้อความหลัก
    // lcd.clear();
    lcd.setCursor(4, 1);
    lcd.print(F("Ready to vote"));
    // ข้อความย่อย
    lcd.setCursor(2, 2);
    lcd.print(F("Waiting for ESP32 (O)"));

    // ล้างกล่องตัวเลขที่อาจค้าง
    for (uint8_t y = 0; y <= 2; y++)
    {
        lcd.setCursor(BOX_LEFT_X, BOX_TOP_Y + y);
        lcd.print(F("     "));
    }

    readyDots = 0;
    lastReadyMs = millis();
}

void animateReady()
{
    unsigned long now = millis();
    // spinner
    if (now - lastSpinMs >= SPIN_MS)
    {
        lastSpinMs = now;
        spinIdx = (spinIdx + 1) & 0x03;
        lcd.setCursor(POS_SPINNER_X, POS_SPINNER_Y);
        lcd.print(spinFrames[spinIdx]);
    }
    // จุด ... ต่อท้าย "Ready to vote"
    if (now - lastReadyMs >= READY_MS)
    {
        lastReadyMs = now;
        readyDots = (readyDots + 1) % 4; // 0..3
        // ลบปลายบรรทัดก่อน
        lcd.setCursor(17, 1);
        lcd.print(F("    "));
        // เขียนจุด
        lcd.setCursor(17, 1);
        if (readyDots == 1)
            lcd.print(F("."));
        else if (readyDots == 2)
            lcd.print(F(".."));
        else if (readyDots == 3)
            lcd.print(F("..."));
    }
}

void drawConfirmUI()
{
    lcd.noBlink();
    loadIcons();
    drawFrame();
    lcd.setCursor(2, 1);
    lcd.print(F("Confirmed:"));
    if (currentChoice == 0)
    {
        lcd.setCursor(13, 1);
        lcd.print(F("Abstain"));
    }
    else
    {
        lcd.setCursor(13, 1);
        lcd.print(F("No."));
        lcd.print(currentChoice);
    }
    lcd.setCursor(1, 2);
    lcd.write((byte)7); // ✓
    lcd.setCursor(18, 2);
    lcd.write((byte)7);
    lcd.setCursor(5, 3);
    lcd.print(F("Saved! Thank you"));
}

/* ===== BUZZER SFX (Arcade pack) ===== */
class BuzzerSFX
{
public:
    void init()
    {
        pinMode(BUZZER_PIN, OUTPUT);
        digitalWrite(BUZZER_PIN, LOW);
        seq = nullptr;
        count = idx = phase = 0;
        phaseEnd = 0;
    }
    void playBoot()
    {
        start(SEQ_BOOT, 4);
    }
    void playClick()
    {
        start(SEQ_CLICK, 1);
    }
    void playClickHi()
    {
        start(SEQ_CLICK_HI, 1);
    }
    void playBack()
    {
        start(SEQ_BACK, 2);
    }
    void playError()
    {
        start(SEQ_ERROR, 3);
    }
    void playConfirm()
    {
        start(SEQ_CONFIRM, 2);
    }
    void playFanfare()
    {
        start(SEQ_FANFARE, 4);
    }

    void update()
    {
        if (!seq || idx >= count)
            return;
        unsigned long now = millis();
        const Step &st = seq[idx];

        if (phase == 0)
        { // start ON
#if BUZZER_PASSIVE
            if (st.freq == 0)
                noTone(BUZZER_PIN);
            else
                tone(BUZZER_PIN, st.freq);
#else
            digitalWrite(BUZZER_PIN, HIGH);
#endif
            phase = 1;
            phaseEnd = now + st.dur;
            return;
        }
        if (phase == 1 && (long)(now - phaseEnd) >= 0)
        { // end ON -> GAP
#if BUZZER_PASSIVE
            noTone(BUZZER_PIN);
#else
            digitalWrite(BUZZER_PIN, LOW);
#endif
            phase = 2;
            phaseEnd = now + st.gap;
            return;
        }
        if (phase == 2 && (long)(now - phaseEnd) >= 0)
        { // next
            idx++;
            phase = 0;
            if (idx >= count)
            {
                seq = nullptr;
            }
        }
    }

private:
    struct Step
    {
        uint16_t freq;
        uint16_t dur;
        uint16_t gap;
    }; // ms

    // โน้ต (Hz)
    enum
    {
        N_C5 = 523,
        N_D5 = 587,
        N_E5 = 659,
        N_F5 = 698,
        N_G5 = 784,
        N_A5 = 880,
        N_B5 = 988,
        N_C6 = 1047,
        N_D6 = 1175,
        N_E6 = 1319,
        N_F6 = 1397,
        N_G6 = 1568,
        N_A6 = 1760
    };

    static const Step SEQ_BOOT[4];
    static const Step SEQ_CLICK[1];
    static const Step SEQ_CLICK_HI[1];
    static const Step SEQ_BACK[2];
    static const Step SEQ_ERROR[3];
    static const Step SEQ_CONFIRM[2];
    static const Step SEQ_FANFARE[4];

    const Step *seq;
    uint8_t count, idx, phase;
    unsigned long phaseEnd;

    void start(const Step *s, uint8_t n)
    {
        // ถ้ากำลังเล่น WAV อยู่ ให้ข้ามไม่เปิดบัซเซอร์ (กันชนกับ TMRpcm)
        // if (tmrpcm.isPlaying()) return;
        seq = s;
        count = n;
        idx = 0;
        phase = 0;
        phaseEnd = 0;
    }
};

// นิยามโน้ตจริง ๆ
const BuzzerSFX::Step BuzzerSFX::SEQ_BOOT[4] = {{BuzzerSFX::N_C5, 90, 15}, {BuzzerSFX::N_E5, 90, 15}, {BuzzerSFX::N_G5, 110, 15}, {BuzzerSFX::N_C6, 150, 0}};
const BuzzerSFX::Step BuzzerSFX::SEQ_CLICK[1] = {{1500, 25, 8}};
const BuzzerSFX::Step BuzzerSFX::SEQ_CLICK_HI[1] = {{1900, 18, 5}};
const BuzzerSFX::Step BuzzerSFX::SEQ_BACK[2] = {{BuzzerSFX::N_E5, 70, 15}, {BuzzerSFX::N_C5, 110, 0}};
const BuzzerSFX::Step BuzzerSFX::SEQ_ERROR[3] = {{400, 140, 35}, {320, 140, 35}, {250, 180, 0}};
const BuzzerSFX::Step BuzzerSFX::SEQ_CONFIRM[2] = {{BuzzerSFX::N_A5, 120, 25}, {BuzzerSFX::N_C6, 140, 0}};
const BuzzerSFX::Step BuzzerSFX::SEQ_FANFARE[4] = {{BuzzerSFX::N_G5, 90, 15}, {BuzzerSFX::N_B5, 90, 15}, {BuzzerSFX::N_D6, 110, 15}, {BuzzerSFX::N_G6, 160, 0}};

BuzzerSFX buzzer;

// ===== Hook: เรียกเมื่อยืนยัน =====
void onConfirmVote(int choice)
{
    Serial.print(F("CF:"));
    Serial.println(choice);
    buzzer.playFanfare(); // ในตัวมันเช็ค tmrpcm.isPlaying() แล้ว
    noteActivity();
}

// ===== Watchdog helpers =====
void wdt_sanity_boot()
{
    MCUSR = 0;
    wdt_disable();
}

[[noreturn]] void reset_via_wdt()
{
    wdt_enable(WDTO_15MS);
    while (true)
    {
    }
}

const uint8_t SD_RETRIES = 3;
void initSD_orReset()
{
    for (uint8_t i = 0; i < SD_RETRIES; ++i)
    {
        if (SD.begin(SD_ChipSelectPin))
        {
            Serial.println(F("SD init OK"));
            return;
        }
        Serial.println(F("SD init failed, retrying..."));
        delay(200);
    }
    Serial.println(F("SD init failed -> resetting via WDT"));
    reset_via_wdt();
}

// ===== App helpers =====
bool playIfIdle(const char *path)
{
    if (tmrpcm.isPlaying())
        return false;
    unsigned long now = millis();
    if (now - lastPlayTime < interval)
        return false;
    tmrpcm.play((char *)path);
    lastPlayTime = now;
    return true;
}

// ---- [ADD] แสดงข้อความ 8 ตัวบน TM1638 (กัน NUL/สั้น/ยาว) ----
void tmShow8(const char *s)
{
    char buf[9];
    uint8_t i = 0;
    for (; i < 8 && s[i]; ++i)
        buf[i] = s[i];
    for (; i < 8; ++i)
        buf[i] = ' ';
    buf[8] = '\0';
    tm.displayText(buf);
}

// ---- [ADD] ฟังก์ชันคำนวณสถานะ + ส่งออกจอ/Serial เมื่อมีการเปลี่ยน ----
void updateElectionState()
{
    unsigned long nowms = millis();
    if (nowms - lastRTCpoll < RTC_POLL_MS)
        return;
    lastRTCpoll = nowms;

    // อ่านเวลาจริง
    DateTime now = rtc.now();

    // ตัดสินสถานะ
    if (now < EWIN.start)
        eState = PREOPEN;
    else if (now <= EWIN.end)
        eState = OPEN;
    else
        eState = CLOSED;

    // อัปเดต TM1638 + ส่ง Serial เฉพาะเมื่อ "สถานะ" เปลี่ยน
    if (eState != lastEState)
    {
        lastEState = eState;

        if (eState == PREOPEN)
        {
            tmShow8(TXT_PRE);
            // อาจเปิด LED สีแดง 1 ดวงบอก “รอ” (ตำแหน่ง 1)
            tm.setLED(TM1638_COLOR_RED, 1);
            tm.setLED(TM1638_COLOR_NONE, 2);
            tm.setLED(TM1638_COLOR_NONE, 3);
            Serial.println(F("STATE:PREOPEN"));
        }
        else if (eState == OPEN)
        {
            tmShow8(TXT_OPEN);
            // เปิด LED สีเขียวบอก “กำลังเปิด” (ตำแหน่ง 2)
            tm.setLED(TM1638_COLOR_NONE, 1);
            tm.setLED(TM1638_COLOR_GREEN, 2);
            tm.setLED(TM1638_COLOR_NONE, 3);
            Serial.println(F("STATE:OPEN"));
        }
        else
        {
            tmShow8(TXT_END);
            // เปิด LED สีแดงหรือปิดทั้งหมดก็ได้ (เอาตามชอบ)
            tm.setLED(TM1638_COLOR_RED, 3);
            tm.setLED(TM1638_COLOR_NONE, 1);
            tm.setLED(TM1638_COLOR_NONE, 2);
            Serial.println(F("STATE:CLOSED"));
        }
    }

    // (ออปชัน) แสดง “นับถอยหลัง” ระหว่าง PREOPEN/OPEN
    // ใช้ตัวเลขอย่างง่ายบน TM1638 เช่น เหลือวินาที / “HHMMSS”
    // คุณจะปรับเป็นรูปแบบอื่นก็ได้
    long remain = 0;
    if (eState == PREOPEN)
        remain = EWIN.start.unixtime() - now.unixtime();
    else if (eState == OPEN)
        remain = EWIN.end.unixtime() - now.unixtime();

    if (remain < 0)
        remain = 0;
    if (eState != CLOSED)
    {
        // แสดงนาทีวินาทีแบบ MMSS (พอดี 4 หลัก; แต่ TM มี 8 หลัก → จัดกึ่งกลาง)
        long mm = remain / 60;
        long ss = remain % 60;
        long mmss = (mm % 100) * 100 + ss; // สูงสุด 99:59
        // แสดงเลื่อนชิดขวา 4 หลักท้าย
        tm.displayIntNum(mmss, true, 4, 4); // (value, leadingZeros, length, pos0-7)
    }
}

// สำหรับหน้าตั้งรหัส
String enteredPass = "";
String savedPass = "1234";
bool fregis = false;
bool regisstatus = false;

void printMaskedAt(uint8_t x, uint8_t y, const String &s)
{
    lcd.setCursor(x, y);
    for (uint8_t i = 0; i < s.length(); i++)
        lcd.print('*');
    for (uint8_t i = s.length(); i < 4; i++)
        lcd.print(' ');
}

void sendPreview()
{
    if (currentChoice < 0)
    {
        // ยังไม่เลือก / ถูก clear
        Serial.println(F("SEL:CLEAR")); // เดิม (debug/compat)
        Serial.println(F("CLR"));       // ใหม่: ล้างจอ TFT
    }
    else if (currentChoice == 0)
    {
        // 0 = งดออกเสียง
        Serial.println(F("SEL:0"));       // เดิม
        Serial.println(F("TXT:Abstain")); // ใหม่: แสดงข้อความ "Abstain" บน TFT
                                          // ถ้าต้องการให้มีรูป 0.jpg ด้วย ก็สั่ง IMG:0 เพิ่ม
                                          // Serial.println(F("IMG:0"));
    }
    else
    {
        // 1..9 = ผู้สมัคร
        Serial.print(F("SEL:"));
        Serial.println(currentChoice); // เดิม
        Serial.print(F("IMG:"));       // ใหม่: แสดงรูป /<n>.jpg
        Serial.println(currentChoice);
    }
    noteActivity();
}

inline void noteActivity()
{
    lastActivityMs = millis();
}

// ===== Vote handler =====
void vote(char k)
{
    if (!canVote)
    {
        buzzer.playError();
        return;
    }

    if (k >= '0' && k <= '9')
    {
        currentChoice = k - '0';
        drawVoteUI_base();
        buzzer.playClick();
        sendPreview(); // → จะส่ง SEL:n ไป ESP32
    }
    else if (k == '*')
    {
        if (currentChoice >= 0)
            buzzer.playBack();
        currentChoice = -1;
        drawVoteUI_base();
        sendPreview();
    }
    else if (k == '#')
    {
        if (currentChoice >= 0)
        {
            page = PAGE_CONFIRM;
            drawConfirmUI();
            onConfirmVote(currentChoice); // ส่ง CF:<n>
            confirmUntil = millis() + 10000UL;
            currentChoice = -1;
            canVote = false;
            tmrpcm.stopPlayback();
            // playIfIdle("fv.wav");
            Serial.println(F("SEL:CLEAR"));
            Serial.println(F("TXT:Saved! Thank you"));
        }
        else
        {
            buzzer.playError();
        }
    }
}

void prepareBeforeSleep()
{
    lcd.noBacklight();
    if (tmrpcm.isPlaying())
        tmrpcm.stopPlayback();
    delay(5);
}

void afterWake()
{
    lcd.backlight();
    page = canVote ? PAGE_VOTE : PAGE_WAIT;
    if (page == PAGE_VOTE)
        drawVoteUI_base();
    else
    {
        drawReadyUI_base();
        Serial.println(F("SEL:CLEAR")); // <-- เพิ่มตรงนี้
    }

    delay(20);
    while (Serial.available())
    {
        String s = Serial.readStringUntil('\n');
    }
    noteActivity();
}

// ============ SETUP / LOOP ============
void setup()
{
    wdt_sanity_boot();
    pinMode(10, OUTPUT);
    Serial.begin(9600);
    Serial.setTimeout(50);

    tmrpcm.speakerPin = 9; // UNO/Nano ใช้ D9
    tmrpcm.setVolume(5);   // 0..7
    tmrpcm.quality(1);

    initSD_orReset();

    Wire.begin(); // UNO: SDA=A4, SCL=A5
    lcd.init();
    lcd.backlight();

    // ==== [ADD] RTC start ====
    if (!rtc.begin())
    {
        // แจ้ง ESP32 ว่า RTC พัง จะได้เข้าระบบ Manual ได้
        Serial.println(F("STATE:RTCERR"));
    }
    else
    {
        // NOTE: ไม่ adjust เวลาอัตโนมัติที่นี่ (เราจะสั่ง SETTIME จาก ESP32 หรือ web)
    }

    // ==== [ADD] TM1638 start ====
    tm.displayBegin(); // init ชิป TM1638
    tm.setLED(TM1638_COLOR_NONE, 1);
    tm.setLED(TM1638_COLOR_NONE, 2);
    tm.setLED(TM1638_COLOR_NONE, 3);
    tm.displayText("PREOPEN "); // ข้อความเริ่มต้น

    // เล่นไฟเปิดเครื่อง (ถ้าหาไฟล์ไม่เจอจะเงียบ)
    tmrpcm.play((char *)"sa.wav");
    if (!tmrpcm.isPlaying())
    {
        tmrpcm.play((char *)"sa.wav");
    }

    buzzer.init();
    // buzzer.playBoot();  // jingle เปิดเครื่อง

    // เริ่มที่หน้า WAIT (Ready)
    canVote = false;
    currentChoice = -1;
    page = PAGE_WAIT;
    drawReadyUI_base();
    Serial.println(F("SEL:CLEAR")); // แจ้ง ESP32 ให้ล้างรูป/ข้อความบน TFT
    Serial.println(F("CLR"));

    kpd.begin(makeKeymap(keys));
    kpd.setDebounceTime(25);
    kpd.setHoldTime(500);

    // === สายปลุกจาก ESP32 ===
    pinMode(ESP_INT_PIN, INPUT_PULLUP);
    attachInterrupt(digitalPinToInterrupt(ESP_INT_PIN), isrEsp, FALLING);

    noteActivity(); // เริ่มนับเวลาตั้งแต่บูต
}

void loop()
{
    // อ่านคีย์จาก keypad
    char k = kpd.getKey();
    if (k)
    {
        noteActivity();

        // === NEW: A/B/C/D ให้คลิกโทนสูงเสมอ แล้วจบเลย ===
        if (k == 'A' || k == 'B' || k == 'C' || k == 'D')
        {
            buzzer.playClickHi();
            return;
        }

        // ถ้ายังไม่ได้รับสิทธิ์ → เมินคีย์ (ยกเว้นหน้า REG_PASS)
        if (!canVote && page != PAGE_REG_PASS)
        {
            buzzer.playError();
        }
        else
        {
            if (page == PAGE_VOTE || page == PAGE_CONFIRM)
            {
                vote(k);
            }
            else if (page == PAGE_REG_PASS)
            {
                // จัดการในส่วน reg pass ด้านล่าง
            }
        }
    }

    // ==== [ADD] ปุ่ม TM1638 เป็นทางลัดผู้ดูแล (FORCE) ====
    static uint8_t lastBtns = 0;
    uint8_t btns = tm.readButtons();
    uint8_t rising = (btns & ~lastBtns);
    lastBtns = btns;

    // K1 กด -> บังคับเปิด (OPEN:FORCE)
    if (rising & 0x01)
    {
        Serial.println(F("STATE:OPEN:FORCE"));
        // แสดงบน TM และ LED ให้เห็นชัด
        tm.displayText("OPEN   ");
        tm.setLED(TM1638_COLOR_NONE, 1);
        tm.setLED(TM1638_COLOR_GREEN, 2);
        tm.setLED(TM1638_COLOR_NONE, 3);
    }

    // K2 กด -> บังคับปิด (CLOSED:FORCE)
    if (rising & 0x02)
    {
        Serial.println(F("STATE:CLOSED:FORCE"));
        tm.displayText("CLOSED ");
        tm.setLED(TM1638_COLOR_NONE, 1);
        tm.setLED(TM1638_COLOR_NONE, 2);
        tm.setLED(TM1638_COLOR_RED, 3);
    }

    // อ่าน Serial: โปรโตคอลอักขระเดี่ยวจาก ESP32
    // ===== รับข้อความจาก ESP32 แบบเป็นบรรทัด =====
    while (Serial.available())
    {
        String line = Serial.readStringUntil('\n');
        line.trim();
        noteActivity();

        if (line.equalsIgnoreCase("S"))
        {
            // กำลังอ่านบัตร
            tmrpcm.play("re.wav");
        }
        else if (line.equalsIgnoreCase("W"))
        {
            // ยังไม่ลงทะเบียน/เพิกถอนสิทธิ์
            canVote = false;
            page = PAGE_WAIT;
            drawReadyUI_base();
            currentChoice = -1;
            tmrpcm.play("n.wav");
            Serial.println(F("SEL:CLEAR"));
            Serial.println(F("CLR"));
        }
        else if (line.equalsIgnoreCase("OK"))
        {
            // บัตร+นิ้วผ่าน (ถ้าต้องการให้เปิดสิทธิ์โหวตทันที ให้ปลดคอมเมนต์ 3 บรรทัดด้านล่าง)
            tmrpcm.play("c.wav");
            canVote = true;
            page = PAGE_VOTE;
            drawVoteUI_base();
        }
        else if (line.equalsIgnoreCase("V"))
        {
            // พร้อมโหวต (อีกทางเลือกจาก ESP32)
            canVote = true;
            page = PAGE_VOTE;
            drawVoteUI_base();
            tmrpcm.play("ch.wav");
            Serial.println(F("TXT:Select 1..9 | #=Confirm | *=Clear"));
        }
        else if (line.equalsIgnoreCase("R"))
        {
            // Toggle โหมดลงทะเบียน (คงพฤติกรรมเดิม)
            fregis = !fregis;
            regisstatus = false;
            enteredPass = "";

            if (fregis)
            {
                page = PAGE_REG_PASS;
                lcd.noBlink();
                lcd.clear();
                lcd.setCursor(2, 0);
                lcd.print(F("Enter pass:"));
                lcd.setCursor(4, 1);
                printMaskedAt(4, 1, enteredPass);
                Serial.println(F("SEL:CLEAR"));
            }
            else
            {
                canVote = false; // ออกจากลงทะเบียนแล้วยังไม่ให้โหวต
                page = PAGE_WAIT;
                drawReadyUI_base();
                Serial.println(F("SEL:CLEAR"));
            }
        }

        // (ออปชัน) ถ้าต้องการ debug เฉพาะบน Serial Monitor ให้เปิดอันนี้
        // แต่ “อย่า” echo ออกไปหา ESP32 ซ้ำ
        // Serial.print(F("[ESP32] ")); Serial.println(line);
    }

    // อนิเมชัน / หน้าคอนเฟิร์ม non-blocking
    if (page == PAGE_WAIT)
        animateReady();
    if (page == PAGE_VOTE)
        animateDuringSelect();
    if (page == PAGE_CONFIRM && (long)(millis() - confirmUntil) >= 0)
    {
        // หลังโชว์ "Confirmed" ถ้ายังมีสิทธิ -> กลับหน้าโหวต, ไม่งั้นกลับหน้า READY
        page = canVote ? PAGE_VOTE : PAGE_WAIT;
        if (page == PAGE_VOTE)
            drawVoteUI_base();
        else
            drawReadyUI_base();
    }

    // หน้า "ตั้งรหัส" (เมื่อ fregis == true)
    if (fregis && page == PAGE_REG_PASS)
    {
        char kk = k; // ใช้คีย์ที่อ่านไว้ข้างบน
        if (kk)
        {
            if (kk >= '0' && kk <= '9')
            {
                if (enteredPass.length() < 4)
                {
                    enteredPass += kk;
                    printMaskedAt(4, 1, enteredPass);
                }
            }
            else if (kk == '*')
            {
                if (enteredPass.length() > 0)
                {
                    enteredPass.remove(enteredPass.length() - 1);
                    printMaskedAt(4, 1, enteredPass);
                }
            }
            else if (kk == '#')
            {
                if (enteredPass.length() == 4)
                {
                    if (enteredPass == savedPass)
                    {
                        // รหัสถูกต้อง -> แจ้งผู้ใช้และส่งสัญญาณไป ESP32
                        lcd.clear();
                        lcd.setCursor(2, 0);
                        lcd.print(F("You can register."));
                        // (ออปชัน) บรรทัดล่างช่วยอธิบาย
                        lcd.setCursor(1, 2);
                        lcd.print(F("Waiting for ESP32..."));
                        Serial.write('R'); // แจ้ง ESP32 ว่า "พร้อมลงทะเบียน"

                        // คงอยู่ในหน้า REG_PASS จนกว่า ESP32 จะตอบกลับ 'R'
                        regisstatus = true; // ใช้เป็นแฟล็กว่าพร้อมออกจากหน้านี้แล้ว
                                            // ไม่ต้องเปลี่ยน page/fregis ที่นี่
                    }
                    else
                    {
                        // รหัสผิด
                        lcd.setCursor(0, 2);
                        lcd.print(F("Wrong pass       "));
                        // (ออปชัน) ล้างรหัสที่พิมพ์ไปแล้ว
                        enteredPass = "";
                        printMaskedAt(4, 1, enteredPass);
                    }
                }
                else
                {
                    lcd.setCursor(0, 2);
                    lcd.print(F("Must be 4 digits "));
                }
            }
        }
    }

    // อัปเดตบัซเซอร์ทุกเฟรม (state machine)
    buzzer.update();

    // ---------- Auto-sleep เมื่อว่าง ----------
    // อย่าหลับตอนกำลังเล่นเสียง
    if (!tmrpcm.isPlaying())
    {
        if ((millis() - lastActivityMs) >= IDLE_SLEEP_MS)
        {
            prepareBeforeSleep(); // ปิด backlight/หยุดเสียง ฯลฯ
            wokeFromEsp = false;  // เคลียร์แฟล็กก่อนหลับ
            goSleepPowerDown();   // หลับลึก (ตื่นด้วย INT1 จาก ESP32)
            afterWake();          // ตื่นแล้วเปิดจอ + วาด UI ใหม่
        }
    }
    updateElectionState();
}
