patt502090/smart-voting-machine/temp/Patt/music/music.ino

#include <SD.h>

#define SD_ChipSelectPin 4
#include <TMRpcm.h>
#include <SPI.h>
char x = '0';
TMRpcm tmrpcm;

void setup() {

  tmrpcm.speakerPin = 9;  //5,6,11 or 46 on Mega, 9 on Uno, Nano, etc

  Serial.begin(9600);
  if (!SD.begin(SD_ChipSelectPin)) {  // see if the card is present and can be initialized:
    Serial.println("SD fail");
    return;  // don't do anything more if not
  }
  Serial.println("test");
  tmrpcm.setVolume(5);
  tmrpcm.quality(1); 
  tmrpcm.play("sawadh.wav"); //the sound file "1" will play each time the arduino powers up, or is reset
}

void loop() {



  if (Serial.available()) {
    x = Serial.read();
 String msg = Serial.readStringUntil('\n');Serial.println("From ESP32: " + msg);
    if (x == '1') {  //ถ้า SerialMonitor ส่งค่า 1 มาให้ Arduino ให้ทำคำสั่งใน if นี้

      tmrpcm.play("1.wav");

    }  //เล่นไฟล์เสียง 1.wav


    if (x == '2') {
      tmrpcm.play("sound/sawadh.wav");  //เล่นไฟล์เสียง 2.wav
    }
    if (x == '3') {
      tmrpcm.play("c.wav");  //เล่นไฟล์เสียง 3.wav
    }
    if (x == '4') {
      tmrpcm.play("re.wav");  //เล่นไฟล์เสียง 4.wav
    }
    if (x == '5') {
      //tmrpcm.play("sound/sawa.wav");  //เล่นไฟล์เสียง 4.wav
    }
    if (x == '6') {
      //tmrpcm.play("sound/sawadlow.wav"); //เล่นไฟล์เสียง 6.wav
    }
    if (x == '7') {
      tmrpcm.play("n.wav");  //เล่นไฟล์เสียง 5.wav
    }
    if (x == '8') {
      tmrpcm.play("sound/choose.wav");  //เล่นไฟล์เสียง 6.wav9

    }
    if (x == '9') {
      tmrpcm.play("sound/finishv.wav");  //เล่นไฟล์เสียง 6.wav
    }

  }
}
