patt502090/smart-voting-machine/temp/Patt/esp32/readsdv2.ino

#include <SPI.h>
#include <SD.h>

// Pin definitions
#define SCK  18
#define MISO 19 
#define MOSI 23
#define SD_CS 13

void listDir(fs::FS &fs, const char * dirname, uint8_t levels){
    Serial.printf("Listing directory: %s\n", dirname);

    File root = fs.open(dirname);
    if(!root){
        Serial.println("Failed to open directory");
        return;
    }
    if(!root.isDirectory()){
        Serial.println("Not a directory");
        return;
    }

    File file = root.openNextFile();
    while(file){
        if(file.isDirectory()){
            Serial.print("  DIR : ");
            Serial.println(file.name());
            if(levels){
                listDir(fs, file.name(), levels -1);
            }
        } else {
            Serial.print("  FILE: ");
            Serial.print(file.name());
            Serial.print("  SIZE: ");
            Serial.println(file.size());
        }
        file = root.openNextFile();
    }
}

void setup(){
    Serial.begin(115200);
    
    // Initialize SPI
    SPI.begin(SCK, MISO, MOSI, SD_CS);
    
    Serial.println("Initializing SD card...");
    
    if(!SD.begin(SD_CS)){
        Serial.println("Card Mount Failed");
        return;
    }
    
    uint8_t cardType = SD.cardType();
    if(cardType == CARD_NONE){
        Serial.println("No SD card attached");
        return;
    }

    Serial.print("SD Card Type: ");
    if(cardType == CARD_MMC){
        Serial.println("MMC");
    } else if(cardType == CARD_SD){
        Serial.println("SDSC");
    } else if(cardType == CARD_SDHC){
        Serial.println("SDHC");
    } else {
        Serial.println("UNKNOWN");
    }

    uint64_t cardSize = SD.cardSize() / (1024 * 1024);
    Serial.printf("SD Card Size: %lluMB\n", cardSize);
    Serial.println();
    
    // List files
    listDir(SD, "/", 0);
}

void loop(){
    // Nothing to do here
    delay(1000);
}
