patt502090/smart-voting-machine/(commit log)

2025-09-15 Add Smart Voting Machine firmware and documentation for Arduino and ESP32
2025-09-16 add esp32
2025-09-16 esp32 blynk
2025-09-17 esp32 rfid and serial with uno
2025-09-19 arduino sync code
2025-09-19 read fingerprint
2025-09-20 refactor: remove esp32 sketch and update dashboard with new features
2025-09-21 update esp32 ultrasonic
2025-09-21 up esp32 new
2025-09-21 add arduino
2025-09-21 arduino update
2025-09-21 update arduino
2025-09-22 edit code arduino for last update
2025-09-23 manage spi 3 device
2025-09-23 update arduino after esp work
2025-09-23 esp32 finally
2025-09-24 edit arduino
2025-09-25 add ultrasonic
2025-09-26 add button
2025-09-26 printer code
2025-09-27 fix: adjust ultrasonic timing and debug logging
    [es.ino]
2025-09-27 fix: update command handling in es.ino
    [es.ino]
2025-09-27 add flag wrong pass
    [lcdver2.ino]
2025-09-28 feat: add SD card file listing functionality and improve error handling
    [es.ino, sd_file_list.ino]
2025-09-28 feat: enhance UART2 message handling during normal scan flow
2025-09-28 feat: enhance input handling by cleaning and debugging UART messages
2025-09-28 feat: refactor EEPROM handling to use ESP32 internal EEPROM exclusively
2025-09-28 refactor: improve UART message handling and enhance selection mode termination
2025-09-28 wake pin D8
2025-09-28 refactor: clean up non-printable characters in SEL commands and improve data handling
2025-09-28 feat: enhance keypad functionality and add delete menu flow
2025-09-28 feat: implement HTTP reset for score deletion and improve confirmation flow
    [es.ino]
2025-09-28 feat: add thermal printer support and print vote receipts
2025-09-28 feat: enhance UART communication and improve card detection logging
2025-09-29 feat: add university logo printing functionality to thermal printer
2025-09-30 Add thermal printer functionality for vote receipt printing
    - Introduced SoftwareSerial for thermal printer communication.
    - Implemented printer initialization and command functions.
    - Added printVoteReceipt function to generate and print voting receipts.
    - Integrated receipt printing into voting flow to ensure a receipt is printed after a vote is cast.
    - Added state management to prevent duplicate receipt printing within a voting session.
    [es.ino]
2025-09-30 Implement double reset functionality to enhance system reset capabilities
    [es.ino]
2025-09-30 Fix function call in registerCardAndFingerprint to improve UI responsiveness
    [es.ino]
2025-09-30 Add debug print statements for successful score and card deletion
2025-09-30 Add handling for register password confirmation in UI flow
2025-09-30 Add delete menu display after fingerprint verification failure
    [es.ino]
2025-09-30 Add functionality for double reset command to restart the system
    [es.ino, lcdver2.ino]
